Larook/STM_Stewart/README.md

# STM_Stewart
Bachelor's thesis in the Warsaw University of Technology.

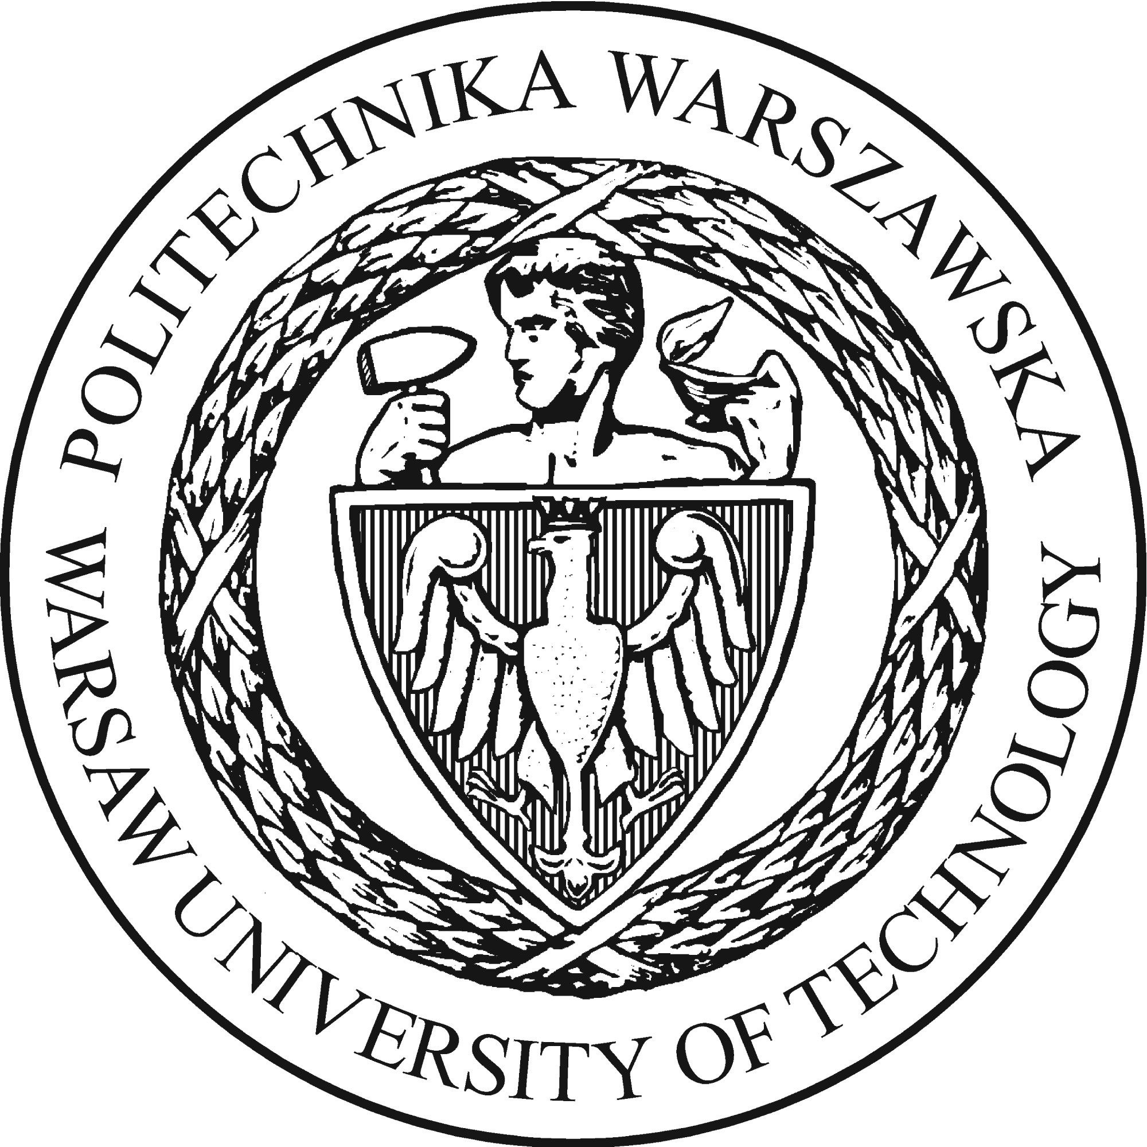
[picture p1: LaTeX_thesis/Thesis_images/logopw.png]


The project's goal was to develop a 6DOF parallel manipulator known as the Stewart platform.
On top of the STM32 - based motion control an attempt to balance a metal ball on top of the platform's upper plate using the resistive touch sensor and PID controller.

- Outcome:
The structure works fine with all the movements possible, combined with gimbal-like stabilisation thanks to the used IMU.
Unfortunately the inaccuracy of servos in the joints were pointed as the main obstacle preventing from succesfull ball balancing on the limited area of top plate.

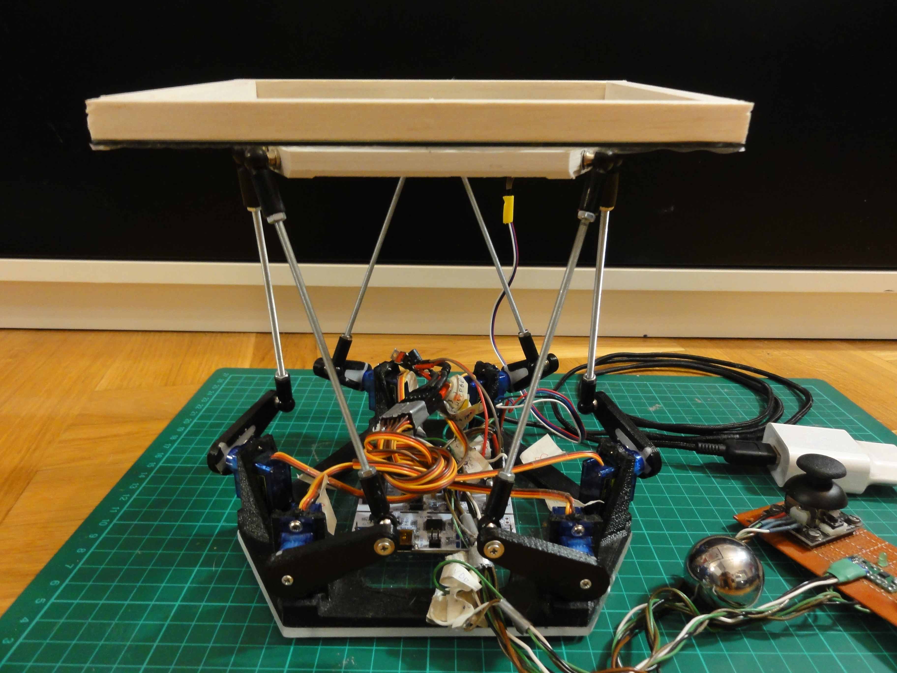
[picture p2: LaTeX_thesis/Thesis_images/Czesci_i_konstrukcja/Platforma_rzeczywista.JPG]


- State machine of operations:

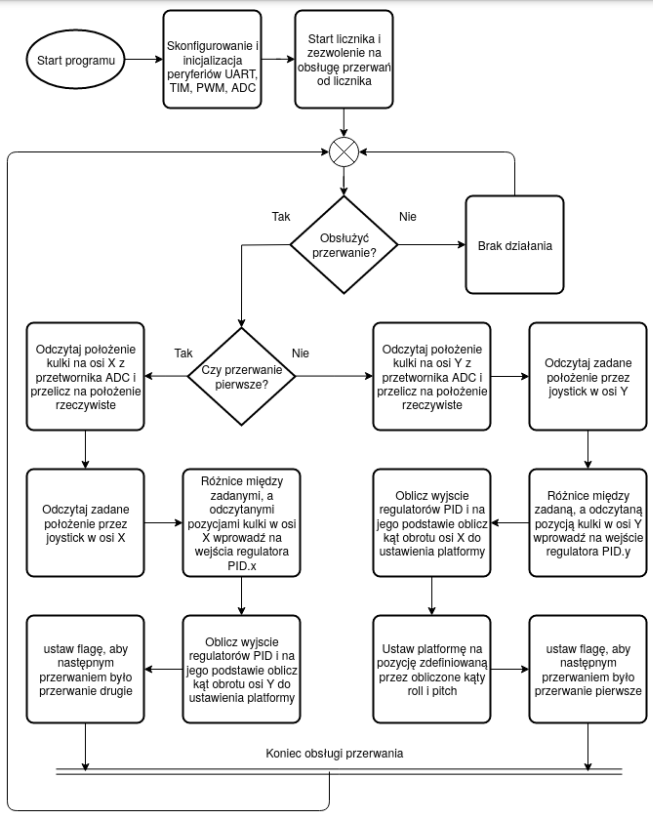
[picture p3: LaTeX_thesis/Thesis_images/statemachine.png]


- Simplified inverse kinematics model:



- Reading the touch data:

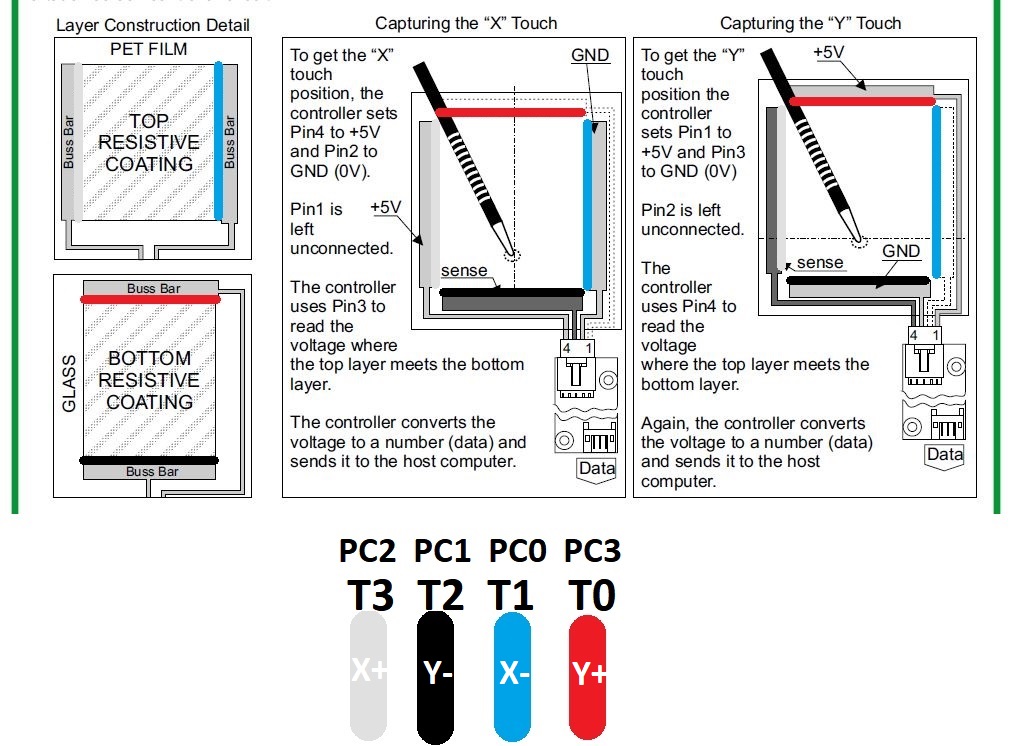
[picture p4: LaTeX_thesis/Thesis_images/TouchPanel/HOW IT SHOULD WORK.jpg]


- PID response:

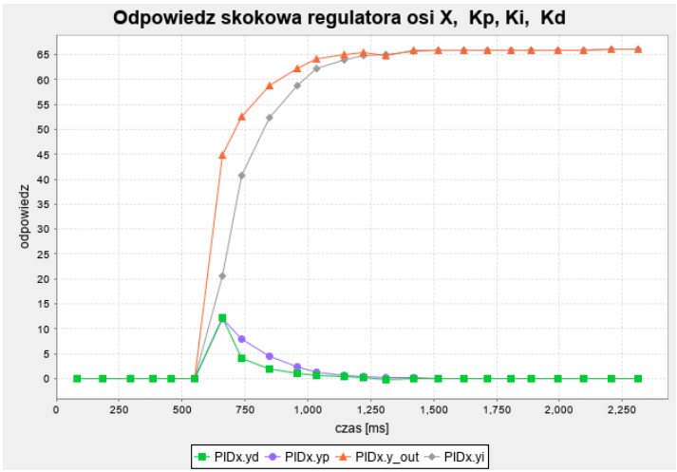
[picture p5: LaTeX_thesis/Thesis_images/step_response.png]
