Larook/STM_Stewart/STM_Stewart-final/LaTeX_thesis/Karol_Szurkowski-Stewart_Platform/tex/5-Sterowanie_polozeniem_kulki.tex

\newpage % Zaleca się otwieranie rozdziału od nowej strony.
\section{Układ sterowania położeniem kulki na platformie za pomoc regulatora PID}

\subsection{Regulator PID - co to, po co, co robi P, I, D, dlaczego to?}

\subsection{zapisany PID w kodzie}

\subsection{Schemat zamkniętej pętli sterowania z nazwami metod kodu}

\subsection{Dobor nastaw i dlaczego kurde nie działa ładnie}
