Larook/STM_Stewart/STM_Stewart-final/LaTeX_thesis/Przykladowe_Papers/chyba_wszystko_dokladnie_Modelling-and-Control-of-Ball-Plate-System.pdf

# Modelling and Control of Ball-Plate System

Final Project Report
Mohammad Nokhbeh and Daniel Khashabi Under the supervision of Dr.H.A.Talebi

Amirkabir University of Technology, 2011

Abstract

Abstract–In this report we will have a detailed look into controlling a Ball-on-Plate system apparatus. We will first derive the exact non-linear differential equations of Ball-on-Plate apparatus by the use of Lagrange-Euler equations. At the rest we derive several useful linearised model for our system. We use the linearised model to design compensator for the system. We simulate the results using non-linear model of system and evaluate the results by step responses and trajectory tracking.

## Contents

1 Introduction | 2
2 Review on Previous Works | 2
3 Mathematical Modelling | 3
3.3.3 | Complete Linearisation of Ball-on-Plate and DC Motor . | 9
4 Controller Design | 10
5 Result Evaluation | 13

1

6 Conclusions | 18
7 Acknowledgement | 18

## 1 Introduction

Balancing systems are one of most challenging problems in Control field. There are lots of platforms for this sake like cart-pole system(inverted pendulum), ball-beam system, double and multiple inverted pendulums[1].
The ball-on-plate system is a promoted version of the traditional ball-on-beam control problem. The problem consists of a plate which its deviation can be manipulated in two perpendicular directions. The goal is to carry the ball moving on the plate to a desired position, that is to control a freely rolling ball on a specific position or moving on a trajectory on the plate. In more precise way, one can do stabilization control in which the goal is to carry the ball from one specific position and hold it in the desired position or do trajectory tracking control in which the goal is to make the ball follow a predefined trajectory with the least error and in a the minimum time.

## 2 Review on Previous Works

We can classify the previous works on ball-on-plate system into to general categories. Those based in mathematical modelling and those proposing model-free controllers.
The [2] is devoted to a mechatronic design of the system which benefits a touch sensor feedback. In [1] a Fuzzy Reinforcement Learning method is proposed. The previous paper benefits a high accuracy stepping motor with 0.9 degree size of steps which is reducible by the drivers down to 1/200 of step size, i.e. 4.5 ∗ 10⁻³
. It uses precise incremental encoder (3600 ppr) which is coupled to motor’s shaft. Altogether by taking the mechanical limitations, it benefits the smallest measurable and applicable amount of rotation 0.1 degrees. It uses a 15 inches touch sensor that its output is a message packet being sent through RS-232 serial communication with 19200 bps. Thus the fastest sampling rate of the whole sensor block is 384 samples per second. This implies that the maximum
available time for decision making is 1/384 ∼= 2.6∗10⁻³ | seconds. The area of the
surface of the touch sensor on which pressure can be sensed 30.41 × 22.81cm. Sensor resolution is 1900*1900 pixels so if the sensor sensitivity is uniformly distributed on its sensitive area, then each pixel is assigned to an area approximately equals to 1.8*1.2 mm² of the surface of the sensor.
In [3] a PID neural network controller(PIDNN) based on genetic algorithm(GA) is used for control. In this approach GA is a applied in training weighting factor of multilayer feed-forward neural network in order to overcome the disadvantage

2

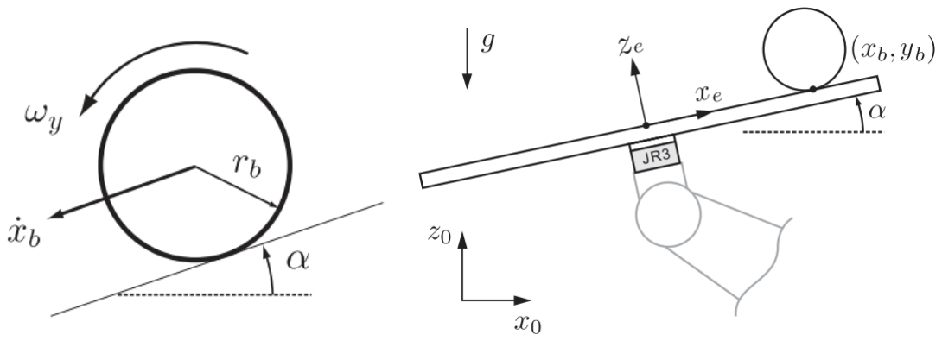
[picture p28: figure]

Figure 1: Side view of ball on plate system.

of back-propagation algorithm which falls into local minima. It is claimed that the proposed method is robust, adaptive and strong control performance.
In [2] ball position measured by a touch pad rather than a camera. In the previous paper a linear quadratic state feedback regulator was designed after the system was linearised around a few operating points. Accuracy of stabilization 5 mm. Steady state error in average was 18 mm in circle following while trajectory velocity was less than 4.2 mm/s
In [4] a hierarchical fuzzy control scheme with a TS type fuzzy tracking controller was proposed. In [5] sliding mode control with uncertain items observe compensation, is used to control a ball-on-plate system.

## 3 Mathematical Modelling

In this section we are going to derive the motion equations of system. In these part we assume following simplifications:

- There is no slipping for ball.
- The ball is completely symmetric and homogeneous.
- All frictions are neglected.
- The ball and plate are in contact all the time.

Here we derive dynamical equations of ball-on-plate system by the help of Lagrangian. The following precise mathematical equations are based on [6][4][7] ([4, 6, 7]). The Euler-Lagrange equation of ball-plate system is as followings:

d
dt

∂T
∂q˙i

−

∂T
∂qi

+

∂V
∂qi
= Qi | (1)

3

Where qi stands for i-direction coordinate, T is kinetic energy of the system, V is potential energy of system and Q is composite force.
The system has 4 degree of freedom; two in ball motion and two in inclination of plate. Here we assume the generalized coordinates of system to be (is) xb and yb ball’s position on plate and α and β the inclination of the plate. It is important to note that we assume the center of x − y coordinates be at center of plate. The kinetic energy of ball consists of its both rotational with respect to its center of mass and translational energy:

Tb =

1
2

mb

x˙

2
b + ẏ

2
b
+

1
2

Ib

ωx

2 + ωy

2
(2)

Where mb is mass of the ball and Ib is moment of inertia of the ball; ẋb and x˙ b are ball’s translational velocities along x-axis and y-axis; ωx and ωy are ball’s rotational velocities along x-axis and y-axis. The following relations between translational velocities and rotational velocities:

x˙ b = rbωy | , | yḃ = rbωx | (3)

In which rb denotes ball’s radius. By substituting equations 3 into equations 4 we will have:

Tb =

1
2
mb
x˙

2
b + ẏ

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
b + ẏ

2
b

=

1
2
mb +

Ib
rb

2

x˙

2
b + ẏ

2
b
(4)

The kinetic energy of the plate, by considering ball as a point mass which is placed in (xb, yb), , consists of the (ezafi) its rotational energy with respect to its center of mass:

Tp =

1/2(Ip + Ib)

α˙

2 + β˙2

+

1
2mb
xbα˙ + ybβ˙
2
| =

1/2(Ip + Ib)

α˙

2 + β˙2

+

1
2mb
x

2
bα˙

2 + 2xbαy˙ bβ˙ + y
2
b

β˙2

(5)

Where α and β are plate’s angle of inclination along x-axis and y-axis, respectively. Therefore ˙α and β˙ are plate’s rotational velocity. Here we can calculate the kinetic energy of system as followings:
Where α and β are plate’s angle of inclination along x-axis and y-axis, respectively. Therefore ˙α and β˙ are plate’s rotational velocity. Here we can calculate the kinetic energy of system as followings: (paragraf tekrari)

T = Tb + Tp
=

1/2
mb +

Ib
rb

2

x˙

2
b + ẏ

2
b
+

1/2(Ip + Ib)

α˙

2 + β˙2

+

1
2mb
x

2
bα˙

2 + 2xbαy˙ bβ˙ + y
2
b

β˙2

(6)

The potential energy of the ball relative (the relative potential) to horizontal plane in the center of the inclined plate can be calculated as:

4

Vb = mbgh = mbg (xb sin α + yb sin β) | (7)

Here we can derive the system’s equation by Lagrangian and equations 4-7:

L = Tb + Tp − Vb | (8)

We use L to derive system’s equations:

∂T
∂α˙

= (Ip + Ia) ˙αx + mbxb

xbα˙ + ybβ˙
,

∂L
∂α = mg cos α | (9)

∂T
∂β˙

= (Ip + Ia)β˙
x + mbyb
ybβ˙ + xbα˙
,

∂L
∂β = mg cos β (10)

∂T
∂xḃ

=

mb +

Ib
r

2
b
xḃ ,

∂L
∂xb

= mb

xbα˙ + ybβ˙
α˙ | (11)

∂T
∂yḃ

=

mb +

Ib
r

2
b
yḃ ,

∂L
∂yb

= mb

xbα˙ + ybβ˙
β˙ | (12)

We assume generalized toques as τx and τy which are exerted torques on the plate. From Lagrange-Euler equation we can write:

d
dt

∂T
∂α˙ −

∂L
∂α | = | (Ip + Ib) ¨α + mbx

2α¨ + 2mbxbxḃα˙ + mbxbybα¨ + mbx˙ bybβ˙ + mbxby˙β˙ − mbg cos α = τx

(13)

d
dt

∂T
∂β˙ −

∂L

∂β | = | (Ip + Ib) β¨ + mby
2
b

β¨ + 2mbybyḃβ˙ + mbxbybβ¨

+ mbyḃxbα˙ + mbybx˙ bα˙ − mbg cos β = τy

(14)

d
dt

∂T
∂x˙ b

−

∂L
∂x˙ b

=

mb +

Ib
r

2
b
x¨b − mb
xbα˙ + ybβ˙
α˙ + mbg sin α = 0 (15)

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
mb +

Ib
r

2
b
y¨b − mb
ybβ˙ + xbα˙
α˙ + mbg sin β = 0 (16)

So the non-linear differential equations for the ball-plate-system as followings:
mb +

Ib
r

2
b
x¨b − mb
xbα˙

2 + ybα˙ β˙

+ mbg sin α = 0 | (17)
mb +

Ib
r

2
b
y¨b − mb
ybβ˙² + xbα˙ β˙
+ mbg sin β = 0 | (18)

τx =

Ip + Ib + mbx

2
b

α¨ + 2mbxbx˙ bα˙ + mbxbybβ¨ +mx˙ bybβ˙ + mbxbyḃβ˙ + mbgxb cos α

(19)

τy =

Ip + Ib + mby

2
b

¨β + 2mbybyḃβ˙ + mbybxbα¨ +mbx˙ bybα˙ + mbxbyḃα˙ + mbgyb cos β

(20)

5

The equations (18)-(17) shows the relation between ball’s state and plate’s state that is plate’s inclination. The equations (19)-(20) shows the effect of external torque on the ball-on-plate system. It is obvious that working with such complex equations is too hard. So in order to do Laplace analysis on system’s transfer function, we derive the linearised model of system in neighbourhood of working state.

### 3.1 Plant Values:

In this report we use the values that are shown in following table that are based on [4]:

Parameter | Description | Value
mb | Mass of the ball | 0.11kg
rb | Radius of the ball | 0.02m
Sp | Dimension of the plate | 1.0 × 1.0m²
vmax | Maximum velocity of the ball | 4mm/s
mp | Mass of the plate | 0.1kg
Ip | Mass moment of inertia of the plate | 0.5kg.m²
Ib | Mass moment of inertia of the ball | 1.76 × 10⁻⁵kg.m²
g | Gravitational acceleration | 9.81

### 3.2 Motor Model

Here we assume (use or consider) an Armature-Controlled DC motor which it’s block diagram is shown in figure 2. The motor uses armature current ia as the control variable. The stator field can be established by a field coil current. The detailed description of equations can be found in [8] and [9]. When we have a constant current in the field coil, we have the following postulates:

Tm(s) = KmIa(s)
V (s) = (Ra + Las)Ia(s) + Ea(s)
V (s) = Kbω(s)
=⇒ Ia(s) = [V (s) − Kbω (s)] / [Ra + Las]

The absolute torque exerted on the load can be found by:

TL(s) = Tm(s) − Td(s)

By letting Td(s) = 0 and considering GL(s) = ωL(s)
TL(s)

to the load torquevelocity characteristic, one can find the input-output transfer function:

G(s) = θL(s)
V (s) =

KmGL(s)
s[(Ra+sLa)+KmKbGL(s)]

6

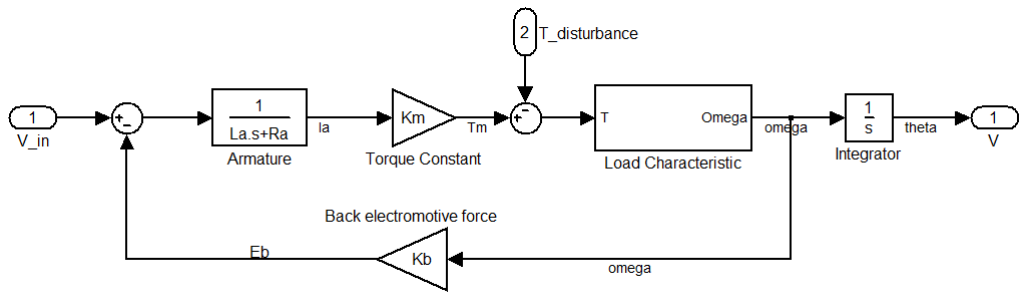
[picture p29: figure]

Figure 2: Block diagram for an armature-controlled DC motor.

We can assume an approximate function for load characteristic as following : TL(s) = 1 Js+B Where J stands for load inertia and B for load damping. We
rewrite the motors transfer function in this way:

G(s) = θL(s)
V (s) =

Km
s[(Ra+sLa)(Js+B)+KmKb]

We assume following typical values for DC motor[10]:

Parameter | Description | Value
Km | Toque constant | 6.876 × 10⁻⁴N.m/A
Kb | Back-emf constant | 7.2 × 10⁻⁵V /rpm or 1.9099 × 10⁻⁷V.s/rad
Jm | Rotor inertia | 1 × 10⁻³N.m.s²/rad
B | Rotor damping | 10⁻⁸N.m/(rad/s)
τf | Field time constant | 1ms
τ | Rotor time constant | 100ms
R | Armature resistance | 3.9Ω
L | Armature inductance | 12 × 10⁻⁶H
Pmax | Maximum output power | 0.25hp
Ts | Stall torque | −4N × m 2.4
Vf l | Rated DC supply voltage | 1.5V

### 3.3 Model Linearisation

In this part we will derive several linearised model of system that we will use them in next sections.

### 3.3.1 Linearised Model of a Ball-on-Plate

The approximate value for a solid ball’s moment of inertia is Iball =

2
5mbr

2
b
Therefore equations (17) and (18) can be written as:

7

mb

5
7

x¨b −

xbα˙

2 + ybα˙ β˙

+ g sin α
= 0 | (21)

mb

5
7

y¨b −

ybβ˙

2
+ xbα˙ β˙
+ g sin β
= 0 | (22)

We can linearise above equation by assuming:

- Small angle of inclination for the plate(up to ± 5

◦
): α 1 and β 1
=⇒ sin α ' α, sin β ' β
- Slow rate of change for the plate: ˙α 0 and β˙ 0 =⇒ α˙ β˙ ' 0 , ˙α | 2 ' 0,
β˙

2
' 0.

5
7
x¨b + gα = 0 | (23)

5
7
y¨b + gβ = 0 | (24)

By linearising the above equations, we find two separate differential equations for each of x and y axis. Note that we can use above linear differential equations to estimate the ball-on-plate system’s states xb, yb, ẋb, ẏb. By assuming α(s) and β(s) as inputs to ball-on-plate system, we find the transfer functions:

Px(s) = Xb(s)
α(s)

=

g
5/7 s

2

(25)

Py(s) = Yb(s)
β(s)

=

g
5/7 s

2

(26)

### 3.3.2 State-space Model of System

One can write state equations of ball-on-plate system by considering Equations (17)-(20)[3]. As mentioned τx and τ y are toques exerted on the plane(or on the ball from the earth) in y-axis and x-axis direction respectively. By defining state variables X = [x1, x2, x3, x4, x5, x6]

T = [xb, x˙ b, α, α, y ˙ b, yḃ, β, β˙ ]

T
,
U = [ux, uy]

T = [α, β]

T
and constant value B = m/ m + Ib/r²
b
| we write the
non-linear state equation x˙ = f(x, u):

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
B(x1x

2
4 + x4x5x8 − g sin x3)
x4
0
x6
B(x5x

2
8 + x1x4x8 − g sin x7)
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
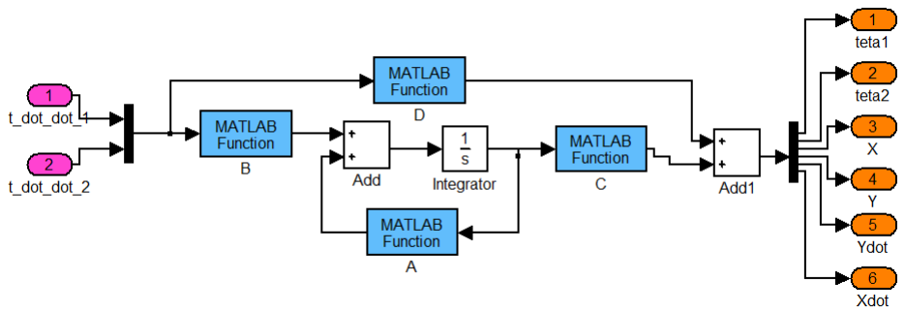
[picture p30: figure]

Figure 3: Block diagram of the Plant.

Because of the low velocity and acceleration of the plate rotation(|α˙ | 1 and

β˙

1) we can omit the coupling term in f(x, u) and divide the system into to sub-systems and control them independently.

x1
x2
x3
x4

=

x2
B(x1x

2
4 − g sin x3)
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
B(x5x

2
8 − g sin x7)
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
The implementation of the plant is shown in figure 3.

### 3.3.3 Complete Linearisation of Ball-on-Plate and DC Motor

We use MATLAB’s internal function to generate a linear model of our non-linear model. First we consider (ezafi) are going to make a linear of model which consists of Plant which is ball-on-plate and a DC motor. The goal of this model is to consider the loading effect of ball and plate on the motor. Because if have ball and plates that have considerable weight, they affect the position/velocity of motor. The complete Simulink model of system is show in figure (5).
The linearisation must be done in infinitesimal neighbourhood of equilibrium point. The equilibrium point is where speed and its derivatives are zero. By considering zero value for velocity and acceleration terms, we find the following point as equilibrium:

9

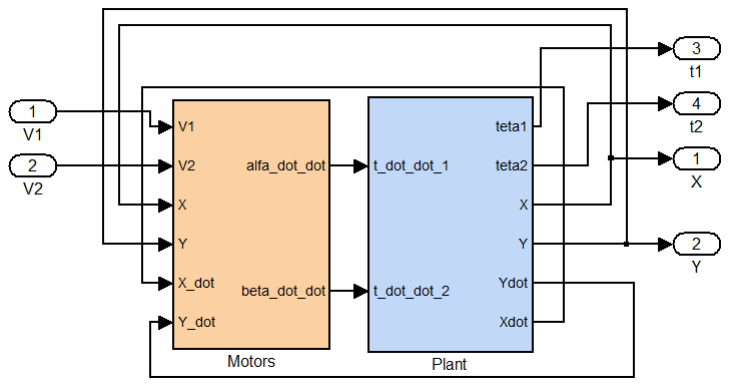
[picture p31: figure]

Figure 4: Block diagram of the whole system.

X = [xb, x˙ b, α, α, y ˙ b, yḃ, β, β˙
]

T = [0, 0, 0, 0, 0, 0, 0, 0]T

MATLAB CODE:
DefineConstants();
[A,B,C,D]=linmod(’PM’,[0,0,0,0,0,0,0,0,0,0,0,0,0,0],[0,0]) sys = ss(A,B,C,D)
sys2=tf(sys)

The resulting output transfer functions are as followings:

X(s) V1(s) = | −802.2
s | 5+3.25×10⁵s 4−15.09s−4.905×10⁶
Y (s) V2(s) = | −802.2
s | 5+3.25×10⁵s 4−15.09s−4.905×10⁶
If we plot the root-locus plot of the above transfer function, we will get the figure (6).

## 4 Controller Design

In this section we are going to design compensator for the transfer functions we derived in previous parts. Here we propose several methods of compensation and in

### 4.1 Single Compensator in Open-Loop

The first compensator consists of only a compensator in open-loop. Unfortunately this system is unproper and DC gain of this controller is 100 (for stabalizing), it’s settling time (Ts) and overshoot is also unacceptable.

10

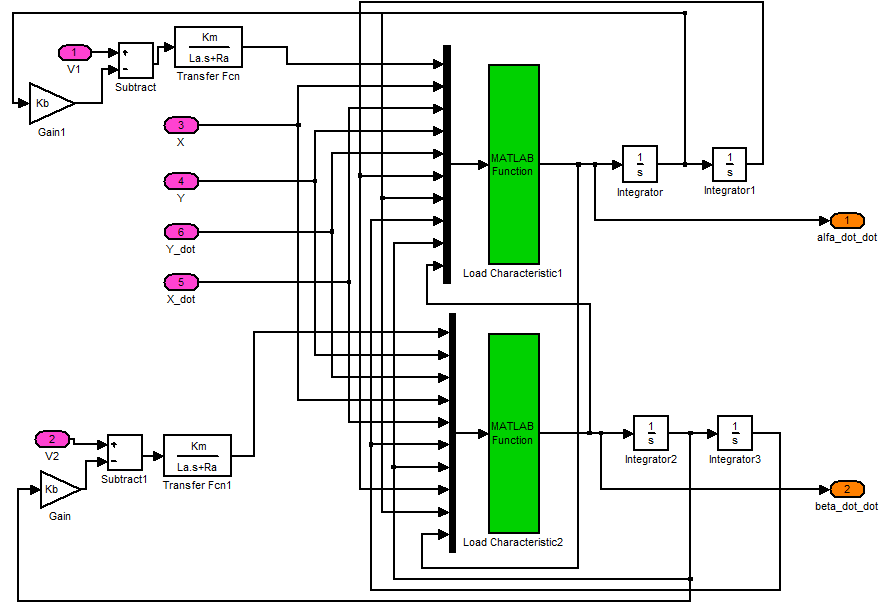
[picture p32: figure]

Figure 5: Block diagram of the motors with non-linear load characteristics.

C(s) = −3461538.4615(s+0.01)² (s+2)(s

2+10s+26)
(s−1.8)(s+100)
Gain | Poles | Zeros
100 | 2 | 5

Root-locus and step response of the first compensator are shown in figure (7).

### 4.2 Compensator With Prefilter

The second compensator consists of a compensator and a prefilter. Unlike first compensator this system is proper and DC gain and percent overshoot of this controller is acceptable but this compensator have a Ts = 15s settling time.

C(s) = −0.4294s

5−139600s

4−323700s

3−705500s

2−1.202×10⁶
s−798.5
s

5+9.971s

4+43.77s

3+111.2s

2+195.5s
F(s) = | 798.5
0.4294s

5+139600s

| 4+323700s 3+705500s

2+1.202×10⁶s+798.5

Gain | Poles | Zeros | Prefilter poles
4.08 | 5 | 5 | 5

In order to find better compensator, we change the architecture add following add a new controlling loop. The compensator at the rest of report are designed to control plant and previous controller.

11

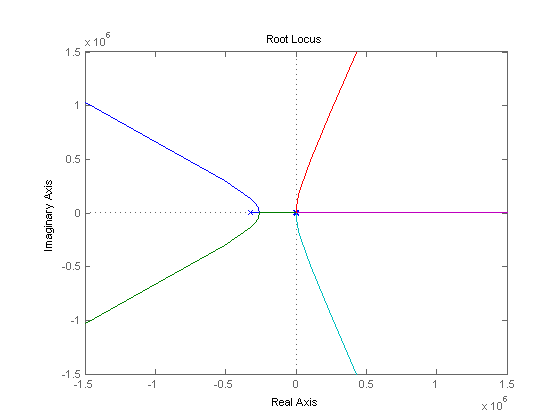
[picture p33: figure]

Figure 6: Pole-zero map of system’s transfer function.

### 4.2.1 Multi-loop controller 1

the following system is designed to make the settling time of second compensator appropriate. this compensator’s aim is to get have overshoot but rapid timerise.

Gain | Poles | Zeros | Prefilter poles
1.6 | 8 | 8 | 1

F(s) = 16.12
s+10
C(s) =

7.296×10¹³s

8+5.597×10¹⁴s

7+1.906×10¹⁵s

6+3.729×10¹⁵s

5+4.586×10¹⁵s

4+3.613×10¹⁵s

3+1.788×10¹⁵s

2+4.917×10¹⁴s+6.251×10¹³
s

8+400s

7+7×10⁴s

6+7×10⁶s

5+4.375×10⁸s

4+1.75×10¹⁰s

3+4.375×10¹¹s

2+6.251×10¹²s+3.907×10¹³

### 4.2.2 Multi-loop controller 2

the following compensator is desinged to make the settling time of second compensator appropriate. this compensator’s aim is to critical damp mode.

Gain | Poles | Zeros | Prefilter poles
.6 | 8 | 8 | 1

F(s) = 26.66
s+10
C(s) =

2.736×10¹³s

8+2.099×10¹⁴s

7+7.148×10¹⁴s

6+1.398×10¹⁵s

5+1.72×10¹⁵s

4+1.355×10¹⁵s

3+6.706×10¹⁴s

2+1.844×10¹⁴s+2.344×10¹³
s

8+400s

7+7×10⁴s

6+7×10⁶s

5+4.375×10⁸s

4+1.75×10¹⁰s

3+4.375×10¹¹s

2+6.251×10¹²s+3.907×10¹³

12

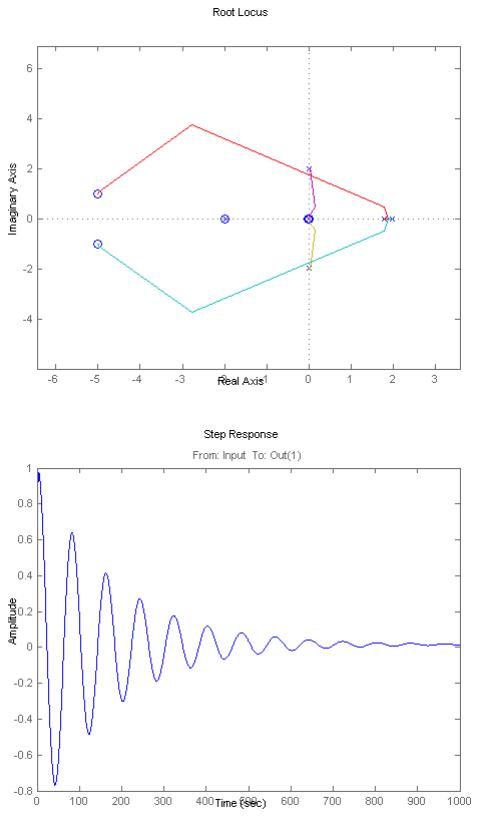
[picture p34: figure]

Figure 7: Root-locus and step response of the first compensator.

## 5 Result Evaluation

In this part we are going to evaluate the results we got from previous parts. The main goal of this part part is to check the validity of the previous results and whether they are valid for the case of main non-linear equations. For this goal, we designed the comprehensive non-linear simulator to check the validity of results.

13

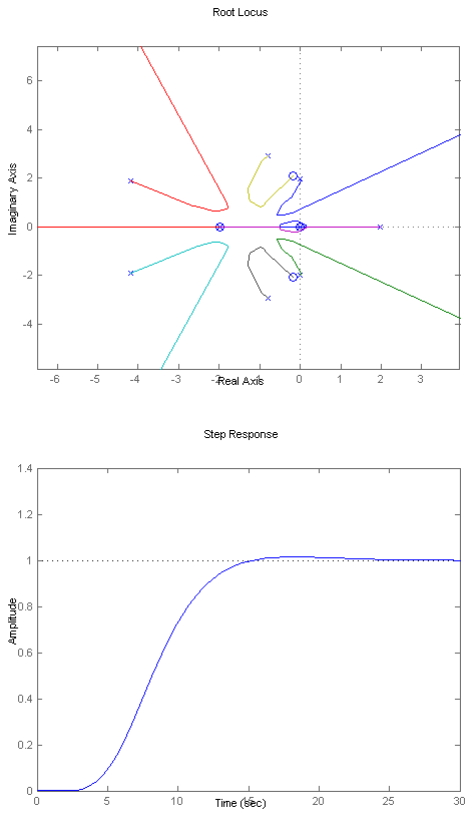
[picture p35: figure]

Figure 8: Root-locus and step response of the second compensator.

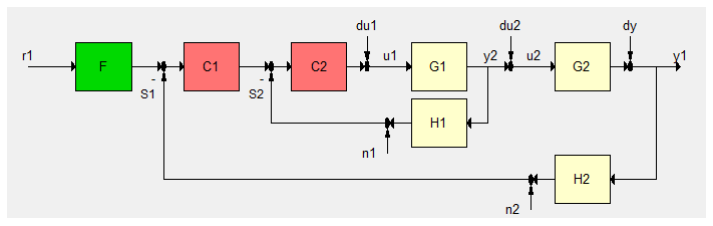
[picture p36: figure]

Figure 9: Architecture of added controlling loop.

14

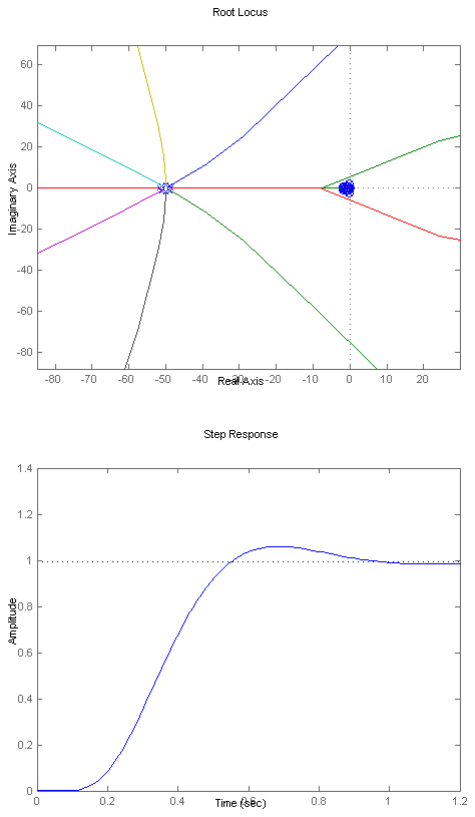
[picture p37: figure]

Figure 10: Root-locus and step response of the third compensator.

### 5.1 Non-linear Simulation

In order to have a realistic evaluation of the designed compensator and its operation we need to design a non-linear simulator by the use of primary non-linear equations (17)-(20).

15

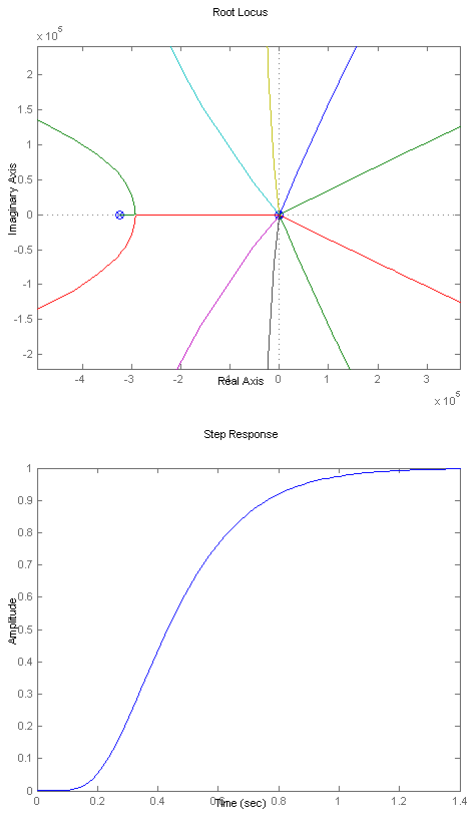
[picture p38: figure]

Figure 11: Root-locus and step response of the forth compensator.

### 5.1.1 Trajectory Tracking Using Non-linear Simulator

The task of tracking a trajectory is one of important tasks that one controller must be able to accomplish. In figure (14) the results of several tracking experiments are shown.

### 5.1.2 Coulomb Friction

Despite the complex microscopic origins of Coulomb friction, we can model it by simple models. One popular model for formulating the Coulomb friction is as following[11] [12] :

16

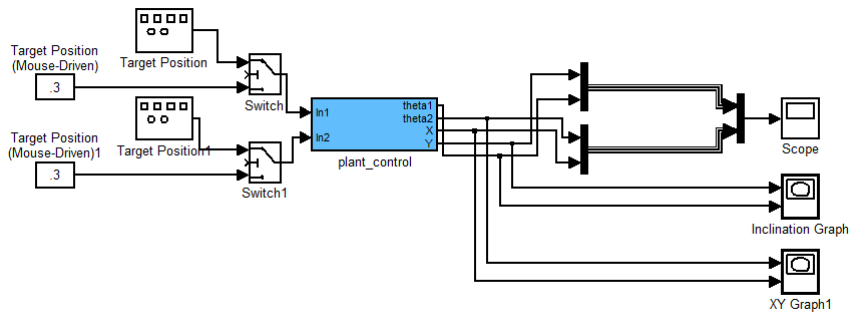
[picture p39: figure]

Figure 12: Main block diagram for simulation in presence of designed controller.

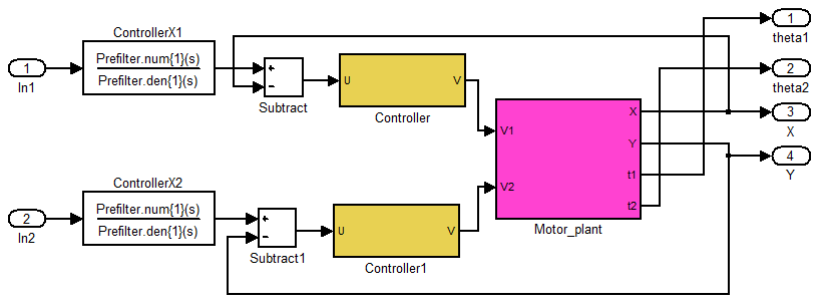
[picture p40: figure]

Figure 13: The designed controllers and non-linear implementation of the system.

Tf = ρ tanh (ηx˙)

Where ρ and η are constant values. For large values of η the Coulomb friction is similar to a Sign Function and for lower values of η we get softer Coulomb friction, as shown in figure (15).

### 5.2 Two-Dimensional Overshoot

As it is described above system’s model is discretely described in each dimension and there is no relation between two subsystem. Consider measuring of overshoot of system, overshoot is the excessive value which systems takes for speed, but what is the relationship between the overshoot measured in each subsystem and overshoot of system. The output signal will be the joint of both systems and because both system’s overshoot times are not equal, system will track an unknown trajectory which is for sure in the rectangle of O1 × O2. Overshoot is usually considered in building of the physical system, the system’s bounds are based on overshoots measured. Considering all above a new measurement of

17 overshoot can be considered which is maximum distance from the zero point in the 2D path. Figure 16 2d-overshoot point (the point with maximum distance of zero) of a joint system consisting of two standard 2nd order linear subsystems are drawn. Assuming ωn1 = ωn2 this will be just in the corner of rectangle, but when ωn1 6= ωn2 this point will be on one of the sides.

H1(s) = ω

2
n1
s
| 2+2ζ1ωn1+ω²
n1
H2(s) = ω

2
n2
s
| 2+2ζ2ωn2+ω²
n2
In figure 17 the 2d-overshoot of different systems with different ζ1 = ζ2 is shown.It shows that systems which their natural frequencies of their subsystems are equal have the worse 2d-overshoot: √
| 2(O1d) (It is also proven with some
other experiments). For example when ωn1 = 1, ωn2 = 1, ζ1 = ζ1 = .6, O2d = 1.5482, but for ωn1 = 1, ωn2 = .5, ζ1 = ζ1 = .6, O2d = 1.4767.

## 6 Conclusions

In this report we derived complete equations of ball-on-plate system. We did linearisation analysis to find the transfer function of the system. We designed several compensator and at the rest made some analysis on the results. We tried several trajectory tracking tasks. The final results showed that the designed controllers had almost acceptable performances.

## 7 Acknowledgement

The authors would like to thank all their classmates, friends and masters that helped on this project. They would like to thank Ehsan Omidi and Farokh Atashzar for their illuminating discussion and ideas. They also knowledge Dr.H.A.Talebi for his comprehensive and off course perfect instructions.

## References

[1] N. Mohajerin, M. B. Menhaj, and A. Doustmohammadi, “A reinforcement learning fuzzy controller for the ball and plate system,” in Proc. IEEE Int Fuzzy Systems Conference, 2010, pp. 1–8.
[2] S. Awtar, C. Bernard, N. Boklund, A. Master, D. Ueda, and K. Craig, “Mechatronic design of a ball-on-plate balancing system,” Mechatronics, vol. 12, no. 2, pp. 217–228, 2002.
[3] X. Dong, Z. Zhang, and C. Chen, “Applying genetic algorithm to on-line updated pid neural network controllers for ball and plate system,” in Proc.

18

Fourth Int Innovative Computing, Information and Control (ICICIC) Conf, 2009, pp. 751–755.

[4] X. Fan, N. Zhang, and S. Teng, “Trajectory planning and tracking of ball and plate system using hierarchical fuzzy control scheme,” Fuzzy Sets and Systems, vol. 144, no. 2, pp. 297–312, 2004.
[5] D. Liu, Y. Tian, and H. Duan, “Ball and plate control system based on sliding mode control with uncertain items observe compensation,” in IEEE International Conference on Intelligent Computing and Intelligent Systems, ICIS09, vol. 2. IEEE, 2009, pp. 216–221.
[6] K. kyu Lee, G. Btz, and D. Wollherr, “Basketball robot: Ball-on-plate with pure haptic information,” in IEEE International Conference on Robotics and Automation, May 2008.
[7] D. Yuan and Z. Zhang, “Modelling and control scheme of the ball-plate trajectory-tracking pneumatic system with a touch screen and a rotary cylinder,” Control Theory & Applications, IET, vol. 4, no. 4, pp. 573–589, 2010.
[8] F. Golnaraghi and B. Kuo, Automatic control systems, vol. 2.
[9] R. Dorf and R. Bishop, Modern control systems, 11th ed. Pearson Printice Hall, 2008.
[10] W. Bolton, Mechatronics: electronic control systems in mechanical and electrical engineering. Prentice Hall, 2004.
[11] D. Haessig and B. Friedland, “On the modeling and simulation of friction,” in American Control Conference. IEEE, 2009, pp. 1256–1261.
[12] C. S.J. and T. R.W., “On the modeling of coulomb friction,” UNKNOWN JOURNAL OR CONFERENCE, 1998.

19

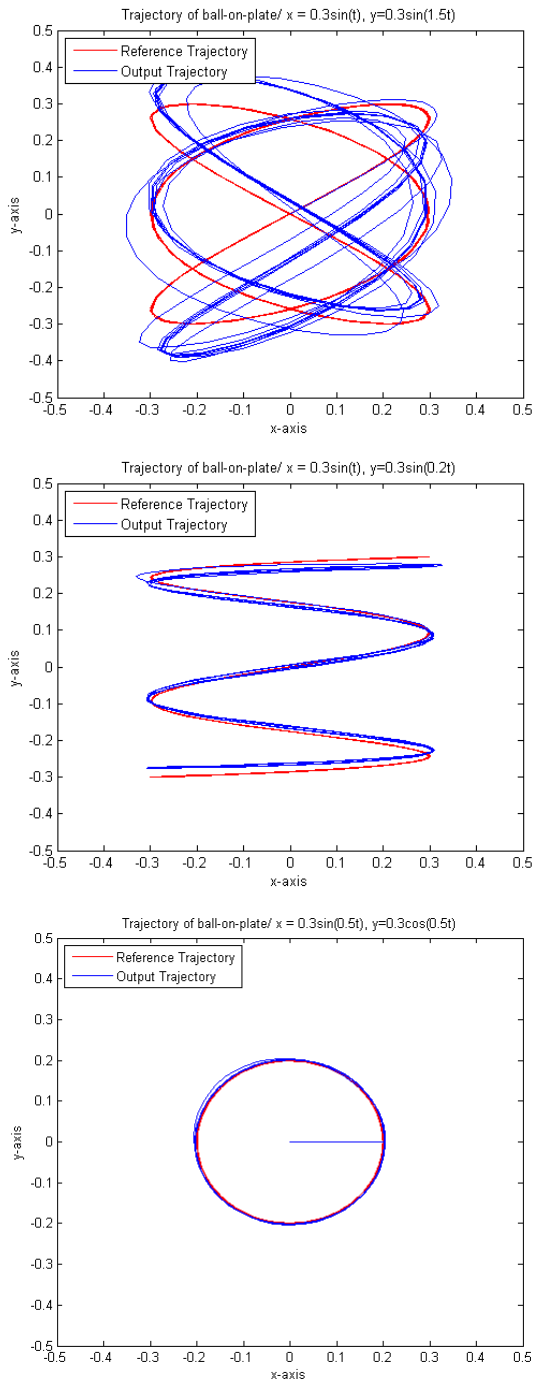
[picture p41: figure]

Figure 14: Results of trajectory tracking.

20

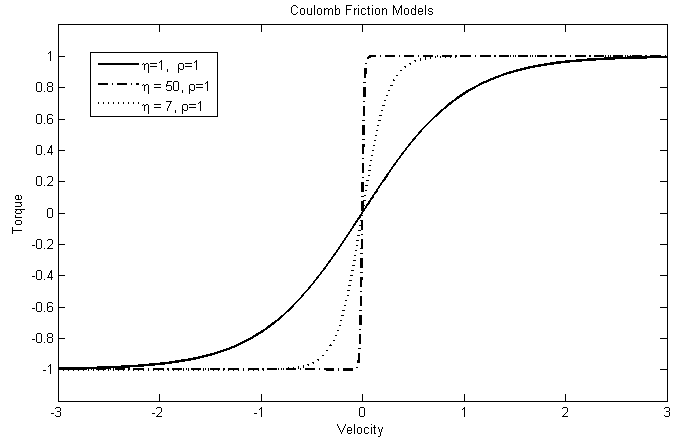
[picture p42: figure]

Figure 15: Coulomb Friction Models.

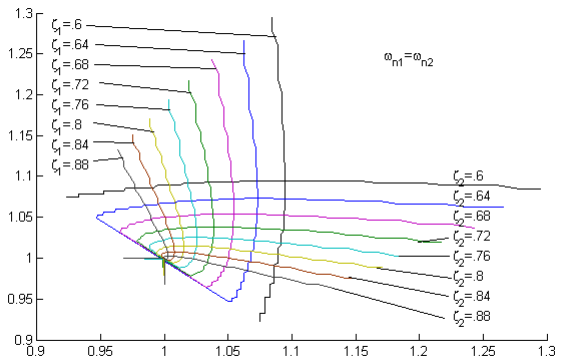
[picture p43: figure]

Figure 16: 2-D overshoot place. This figure shows the point which has the maximum distance from zero for different parameters of ζ1 and ζ2. Each curve is a class of systems which have one subsystem and the other subsystem differs.

21

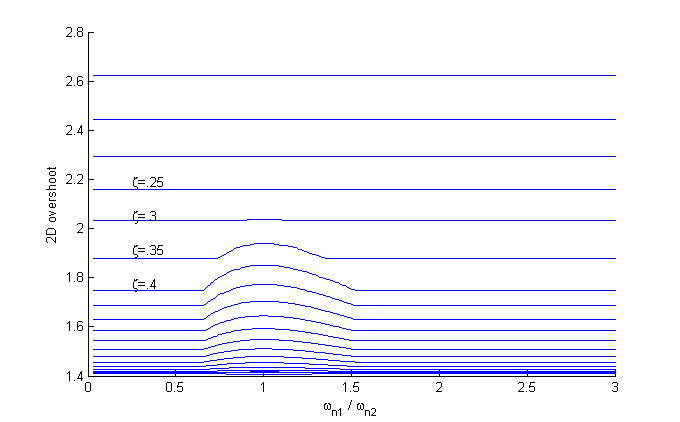
[picture p44: figure]

Figure 17: 2-D overshoot. This figure shows the the maximum distance from zero for different systems with ζ1 = ζ2 according to their subsystems natural frequencies ratios.

22
