Larook/STM_Stewart/STM_Stewart-final/LaTeX_thesis/Karol_Szurkowski-Stewart_Platform/main.tex

%%%%%%%%%%%%%%%%%%%%%%%%%%%%%%%%%%%%%%%%%%%%%%%%%%%%%%%
%% Engineer & Master Thesis, LaTeX Template          %%
%% Copyleft by Piotr Woźniak & Artur M. Brodzki      %%
%% Faculty of Electronics and Information Technology %%
%% Warsaw University of Technology, Warsaw, 2019     %%
%%%%%%%%%%%%%%%%%%%%%%%%%%%%%%%%%%%%%%%%%%%%%%%%%%%%%%%

% dobry wzor do pisania pracki wg. prof doc dr mag inz Wiraszki
%%https://www.overleaf.com/read/kxhnmbgdyjnb

\documentclass[
    left=2.5cm,         % Sadly, generic margin parameter
    right=2.5cm,        % doesnt't work, as it is
    top=2.5cm,          % superseded by more specific
    bottom=3cm,         % left...bottom parameters.
    bindingoffset=6mm,  % Optional binding offset.
    nohyphenation=false % You may turn off hyphenation, if don't like. 
]{eiti/eiti-thesis}

\usepackage[polish]{babel}
\usepackage[
    backend=bibtex,
    style=ieee
]{biblatex}
\usepackage{csquotes}
\usepackage{wrapfig}
\usepackage{graphicx}

\graphicspath{{img/}}             % Katalog z obrazkami.
\addbibresource{bibliografia.bib} % Plik .bib z bibliografią

%----------------------------------------
% Twierdzenia i definicje;
% tutaj ew. tłumaczymy te terminy
% na inne języki
%----------------------------------------
\newtheorem{theorem}{Twierdzenie}
\newtheorem{lemma}{Lemat}
\newtheorem{corollary}{Wniosek}
\newtheorem{definition}{Definicja}
\newtheorem{axiom}{Aksjomat}
\newtheorem{assumption}{Założenie}

%----------------------------------------
% Spis rysunków, tablic i załączników;
% tutaj ew. tłumaczymy te terminy
% na inne języki
%----------------------------------------
\AtBeginDocument{
    \renewcommand{\listfigurename}{Spis rysunków}
    \renewcommand{\listtablename}{Spis tabel}
    \renewcommand{\tablename}{Tabela}
}

\begin{document}

%--------------------------------------
% Strona tytułowa
%--------------------------------------
\EngineerThesis % dla pracy inżynierskiej mamy \EngineerThesis
\instytut{XXXXXX}
\kierunek{Automatyka i Robotyka Stosowana}
\specjalnosc{XXXXXX}
\title{
    Niepotrzebnie długi i skomplikowany tytuł pracy \\ 
    coś o platformie Stewarta - manipulatorze o sześciu stopniach swobody 
}
\engtitle{ % Tytuł po angielsku do angielskiego streszczenia
    Unnecessarily long and complicated thesis' title \\
    difficult to read, understand and pronounce
}
\author{\{Imię i Nazwisko\}}
\album{XXXXXX}
\promotor{XXXXXX}
\date{\the\year}
\maketitle

%--------------------------------------
% Streszczenie po polsku
%--------------------------------------
\streszczenie \lipsum[1-3]
\slowakluczowe XXX, XXX, XXX
\newpage

%--------------------------------------
% Streszczenie po angielsku
%--------------------------------------
\abstract \kant[1-3]
\keywords XXX, XXX, XXX
\newpage

%--------------------------------------
% Oświadczenie o autorstwie
%--------------------------------------
\makeauthorship
\blankpage

%--------------------------------------
% Spis treści
%--------------------------------------
\thispagestyle{empty}
\tableofcontents
\cleardoublepage

%--------------------------------------
% Rozdziały
%--------------------------------------
\input{tex/1-Wstep.tex}         % W długich pracach
\input{tex/2-Projektowanie_konstrukcji_mechanicznej_i_dobor_komponentow.tex}    % wygodnie jest trzymać
\input{tex/3-Zagadnienie_kinematyki_odwrotnej_platformy.tex}
\input{tex/4-Wykorzystanie_panelu_dotykowego.tex} % każdy rozdział w osobnym pliku. 
\input{tex/5-Sterowanie_polozeniem_kulki.tex}

\newpage % Zaleca się otwieranie rozdziału od nowej strony
\section{Podsumowanie}      % Ale można też pisać w jednym. 
\lipsum[5-7]

%--------------------------------------------
% Literatura
%--------------------------------------------
\newpage
\printbibliography

%--------------------------------------------
% Spisy (opcjonalne)
%--------------------------------------------
\newpage

% Wykaz symboli i skrótów.
% Pamiętaj, żeby posortować symbole alfabetycznie
% we własnym zakresie. Ponieważ mało kto używa takiego wykazu, 
% uznałem, że robienie automatycznie sortowanej listy
% na poziomie LaTeXa to za duży overkill. 
% //AB
\vspace{0.8cm}
\begin{acronym}
    \item \textbf{EiTI} -- Wydział Elektroniki i Technik Informacyjnych
    \item \textbf{PW} -- Politechnika Warszawska
\end{acronym}
\vspace{1cm}                % vertical space

\listoffigures              % Spis obrazków. 
\vspace{1cm}                % vertical space
\listoftables               % Spis tabel. 
\vspace{1cm}                % vertical space

% TUTAJ WRZUCAM WSZYSTKIE LINKI NA RAZIE - PDFY I ZDJECIA
\begin{appendix}            % Spis załączników.  
    \item https://arxiv.org/pdf/1712.02923.pdf
    \item https://wiku.wordpress.com/2007/05/23/stewart-platform/
    \item https://ovaktechnologies.com/wp-content/uploads/2016/07/Stewart\%20Platform.jpg
    \item https://www.researchgate.net/figure/Coordinates-of-6-DOF-Stewart-platform\_fig1\_264815673
    \item https://repository.up.ac.za/bitstream/handle/2263/25175/01chapter1.pdf?sequence=2
    \item http://www.hagenbuch.ch/hagenbuch/englisch/Download_Produkte/Hexapod\%20Applications.pdf
    \item https://ch.mathworks.com/company/newsletters/articles/creating-a-stewart-platform-model-using-simmechanics.html
    \item https://www.researchgate.net/publication/224831217\_Dynamic\_Modeling\_and\_Simulation\_of\_Stewart\_Platform
    \item http://www.parallemic.org/Reviews/Review007.html
\end{appendix}

% Możesz też dodać swój własny spis, 
% np. spis algorytmów. 
% \begin{spis}{algorytmów}
%     \item Algorytm 1.
%     \item Algorytm 2.
% \end{spis}

\end{document} % Dobranoc.
