Larook/STM_Stewart/STM_Stewart-final/LaTeX_thesis/Karol_Szurkowski-Stewart_Platform/tex/4-Wykorzystanie_panelu_dotykowego.tex

\newpage % Zaleca się otwieranie rozdziału od nowej strony.
\section{Budowa i wykorzystanie rezystancyjnego panelu dotykowego}

\subsection{Roznice miedzy rezystancyjnym a pojemnosciowym panelem dotykowym}

\subsection{Skomplikowany sposob na odczytywanie polozenia i zmiana konfiguracji pinow w trakcie wykonywania programu}

\subsection{Majac wyniki odczytow z przetwornika ADC trzeba je zrzutować na wartości mówiące coś w rzeczywistości - mapowanie za pomocą algorytmów wykorzystywanych do wyświetlaczy dotykowych + kod w Pythonie}
