Larook/STM_Stewart/LaTeX_thesis/Thesis_images/Czesci_i_konstrukcja/dostepne_timery_pwm_13.png

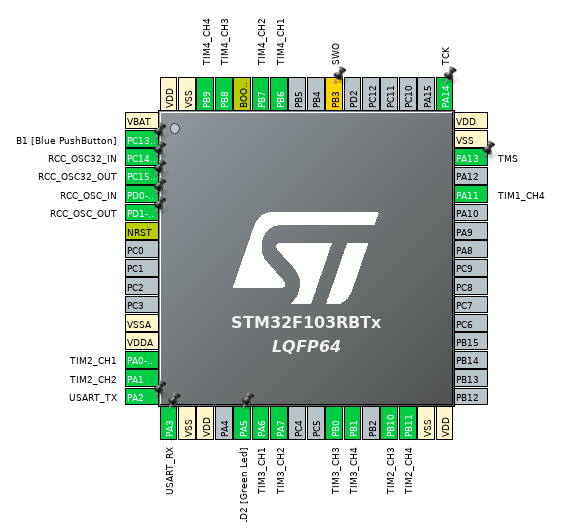
LaTeX_thesis/Thesis_images/Czesci_i_konstrukcja/dostepne_timery_pwm_13.png
