Larook/STM_Stewart/LaTeX_thesis/Thesis_images/Czesci_i_konstrukcja/Schemat_elektryczny.png

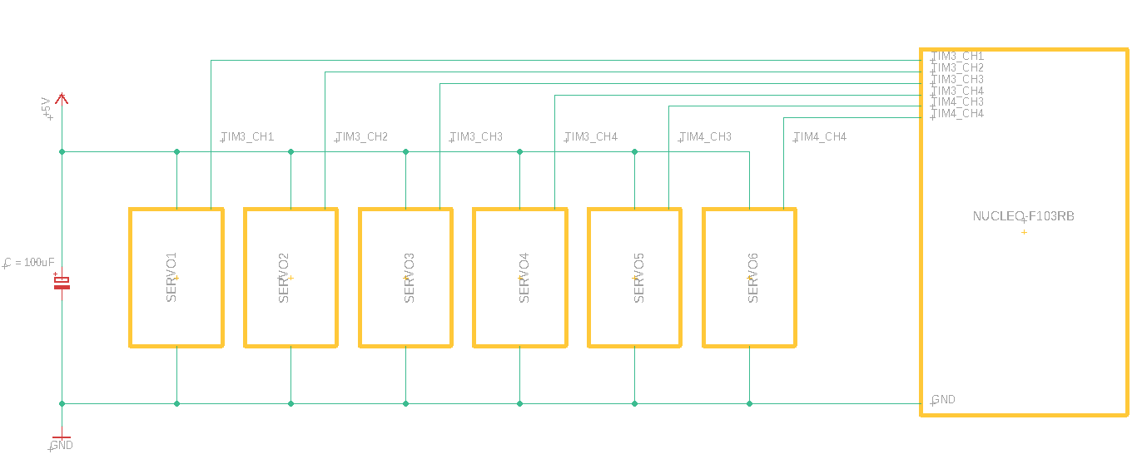
LaTeX_thesis/Thesis_images/Czesci_i_konstrukcja/Schemat_elektryczny.png
