Larook/STM_Stewart/LaTeX_thesis/Thesis_images/Czesci_i_konstrukcja/Wykorzystane_piny_mcu.png

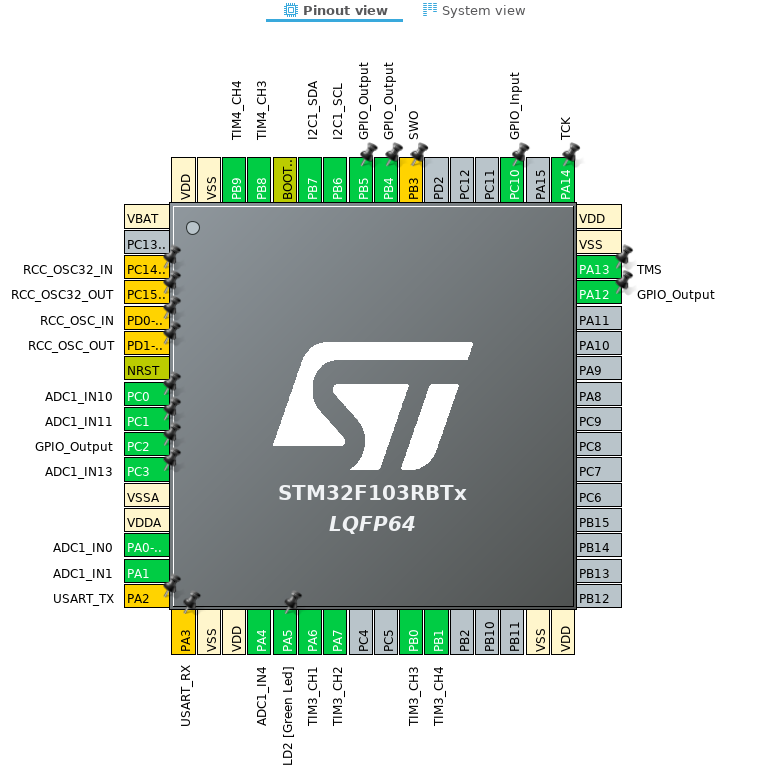
LaTeX_thesis/Thesis_images/Czesci_i_konstrukcja/Wykorzystane_piny_mcu.png
