Larook/STM_Stewart/LaTeX_thesis/Thesis_images/Inventor/serwo_orczyk_calosc.JPG

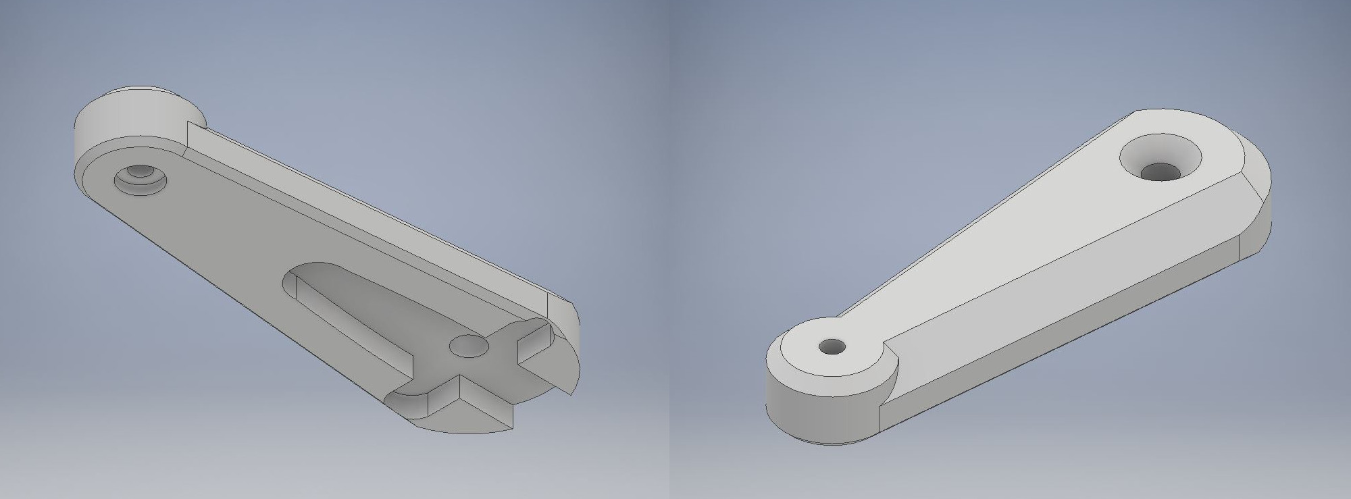
LaTeX_thesis/Thesis_images/Inventor/serwo_orczyk_calosc.JPG
