Larook/STM_Stewart/LaTeX_thesis/Thesis_images/Wstep/GoughPlatform.jpg

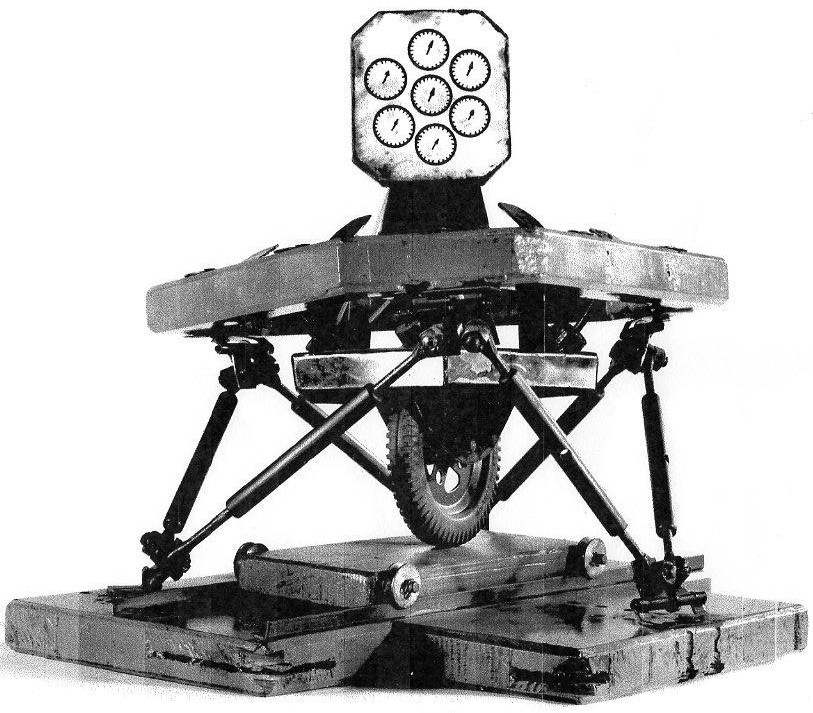
LaTeX_thesis/Thesis_images/Wstep/GoughPlatform.jpg
