Larook/STM_Stewart/STM_Stewart-final/LaTeX_thesis/Karol_Szurkowski-Stewart_Platform/img/6-DOF.jpg

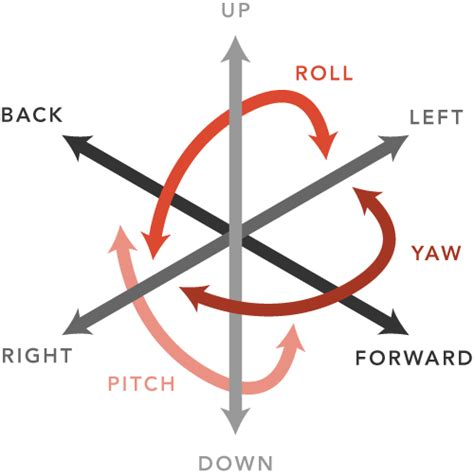
STM_Stewart-final/LaTeX_thesis/Karol_Szurkowski-Stewart_Platform/img/6-DOF.jpg
