Larook/STM_Stewart/STM_Stewart-final/LaTeX_thesis/Karol_Szurkowski-Stewart_Platform/img/Boeing_737_Full_Motion_Flight_Simulator-1024x768.jpg

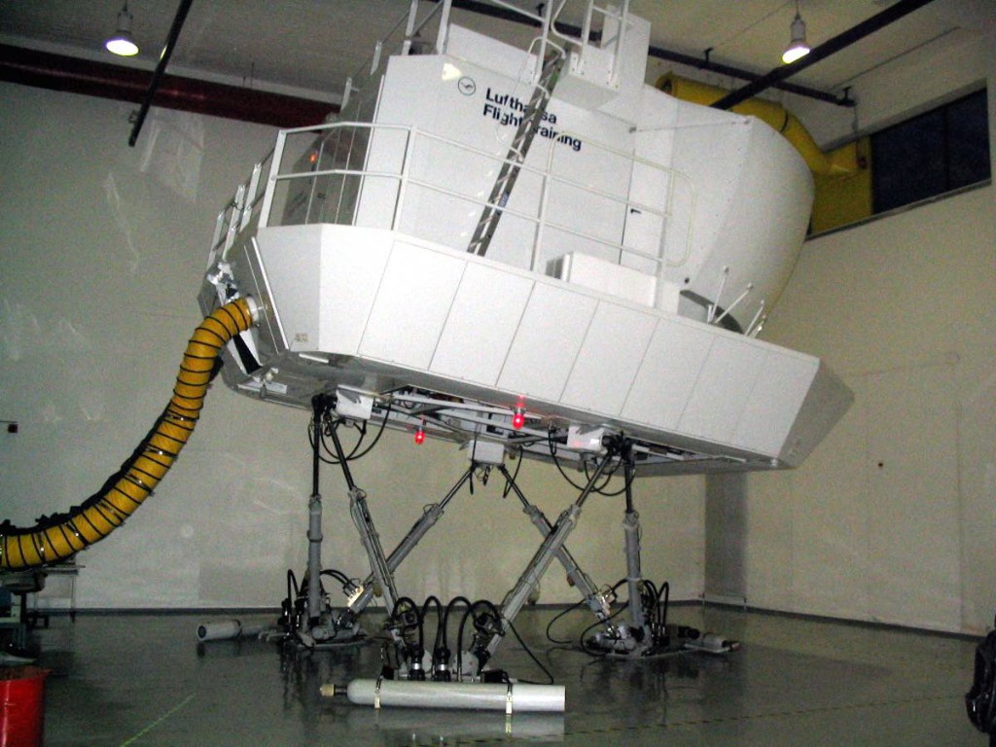
STM_Stewart-final/LaTeX_thesis/Karol_Szurkowski-Stewart_Platform/img/Boeing_737_Full_Motion_Flight_Simulator-1024x768.jpg
