Larook/STM_Stewart/STM_Stewart-final/LaTeX_thesis/Karol_Szurkowski-Stewart_Platform/img/GoughPlatform.jpg

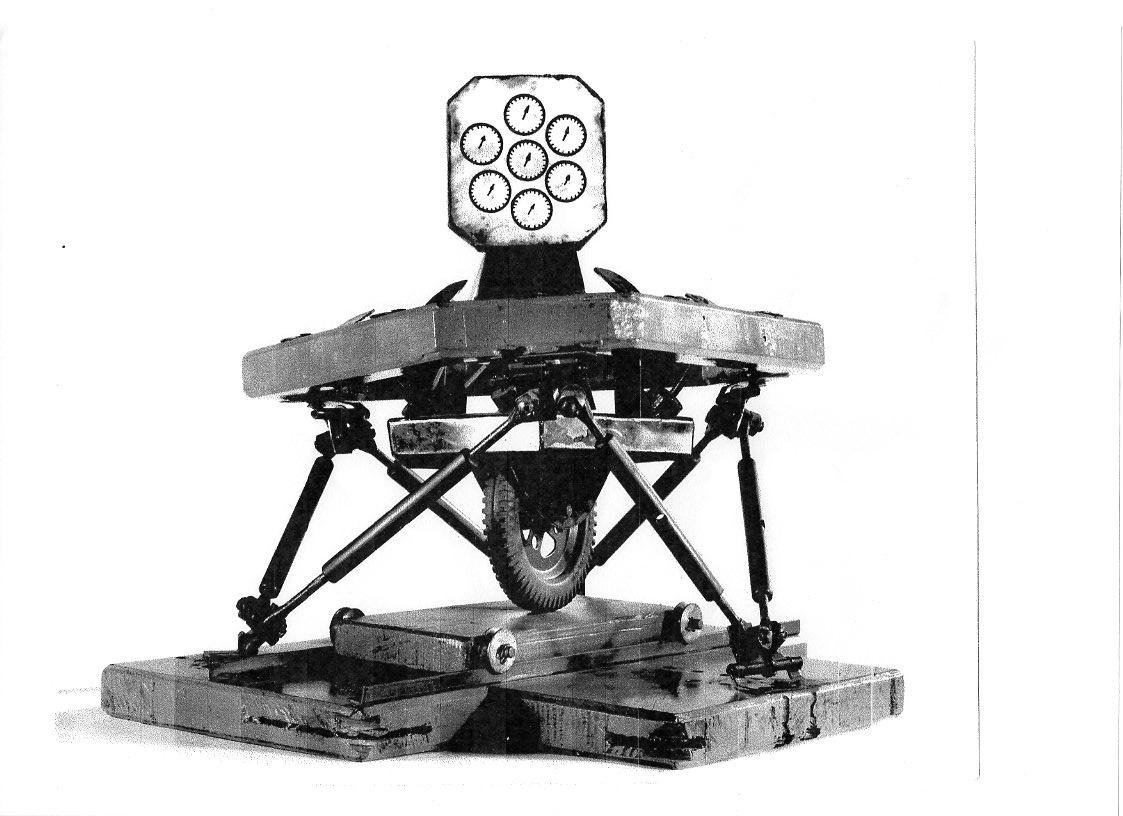
STM_Stewart-final/LaTeX_thesis/Karol_Szurkowski-Stewart_Platform/img/GoughPlatform.jpg
