Larook/STM_Stewart/STM_Stewart-final/LaTeX_thesis/Karol_Szurkowski-Stewart_Platform/img/medical_surgery_stewart.png

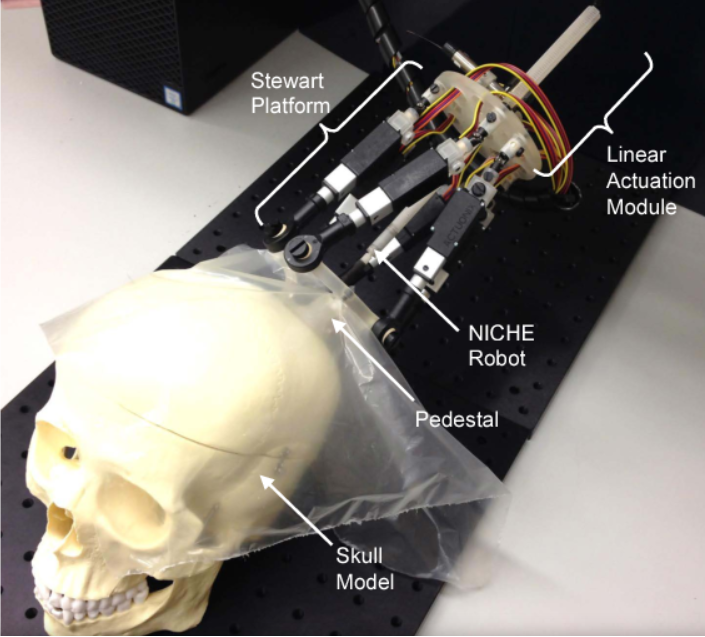
STM_Stewart-final/LaTeX_thesis/Karol_Szurkowski-Stewart_Platform/img/medical_surgery_stewart.png
