Larook/STM_Stewart/STM_Stewart-final/LaTeX_thesis/Karol_Szurkowski-Stewart_Platform/img/TopPlate_UP.JPG

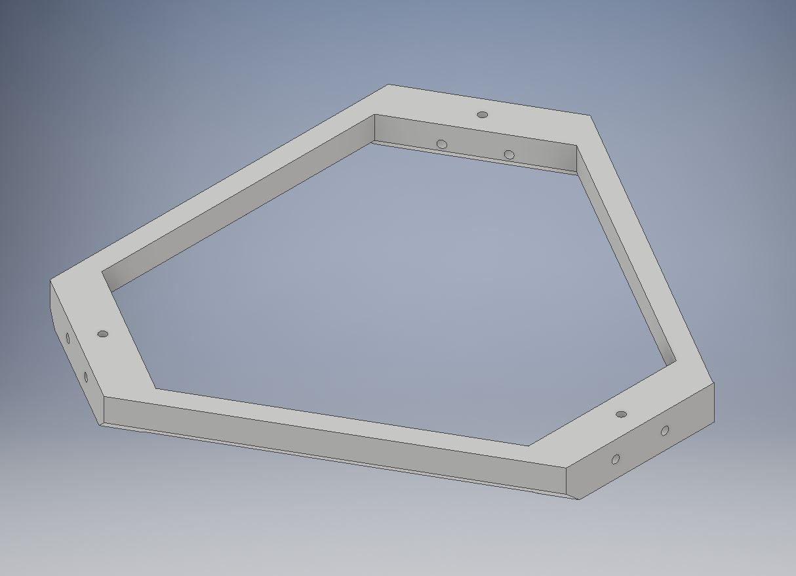
STM_Stewart-final/LaTeX_thesis/Karol_Szurkowski-Stewart_Platform/img/TopPlate_UP.JPG
