Larook/STM_Stewart/STM_Stewart-final/LaTeX_thesis/Karol_Szurkowski-Stewart_Platform/img/wybor_serwomechanizmu.png

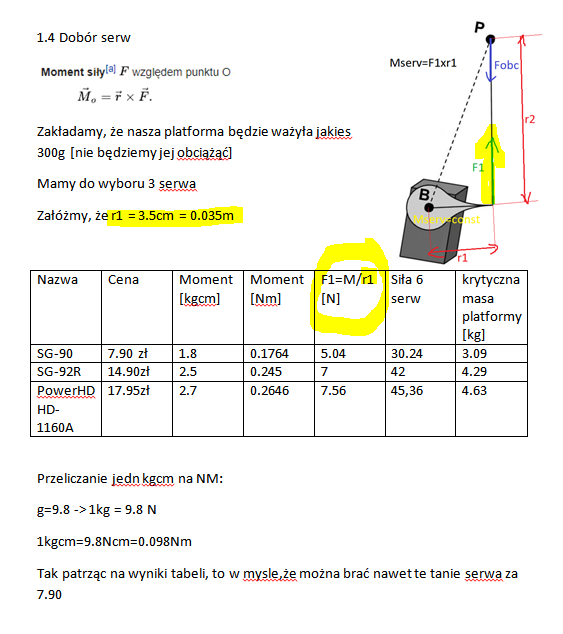
STM_Stewart-final/LaTeX_thesis/Karol_Szurkowski-Stewart_Platform/img/wybor_serwomechanizmu.png
