Larook/STM_Stewart/STM_Stewart-final/LaTeX_thesis/Thesis_images/Czesci_i_konstrukcja/NUCLEO-F103RB-5.png

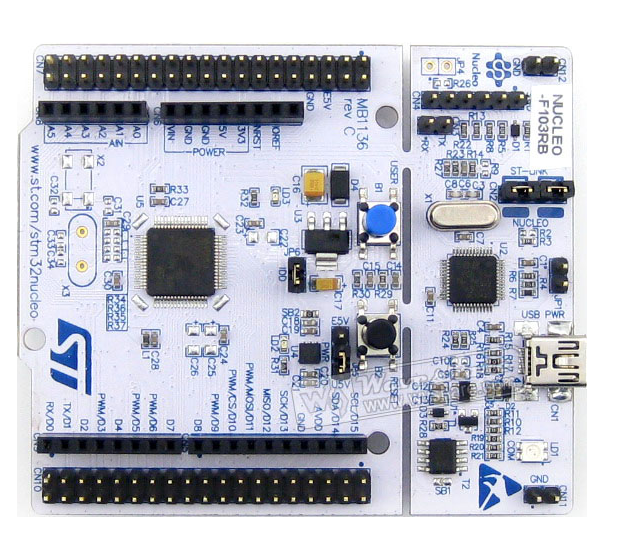
STM_Stewart-final/LaTeX_thesis/Thesis_images/Czesci_i_konstrukcja/NUCLEO-F103RB-5.png
