Larook/STM_Stewart/STM_Stewart-final/LaTeX_thesis/Thesis_images/Czesci_i_konstrukcja/Platforma_rzeczywista_wspolrzedne_1.jpg

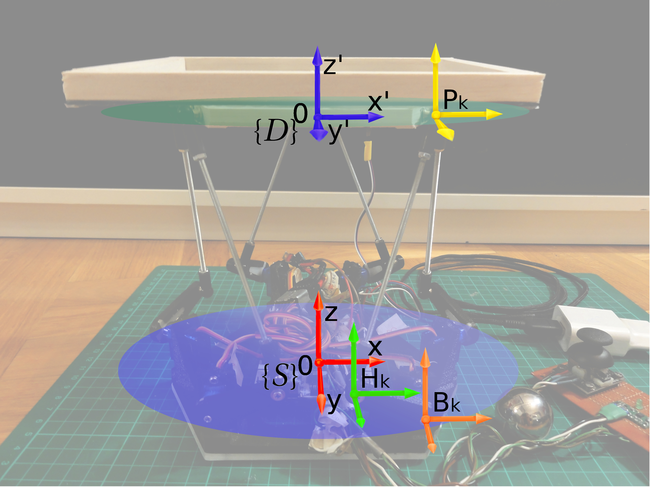
STM_Stewart-final/LaTeX_thesis/Thesis_images/Czesci_i_konstrukcja/Platforma_rzeczywista_wspolrzedne_1.jpg
