Larook/STM_Stewart/STM_Stewart-final/LaTeX_thesis/Thesis_images/Czesci_i_konstrukcja/projekt_2d_podstawy.png

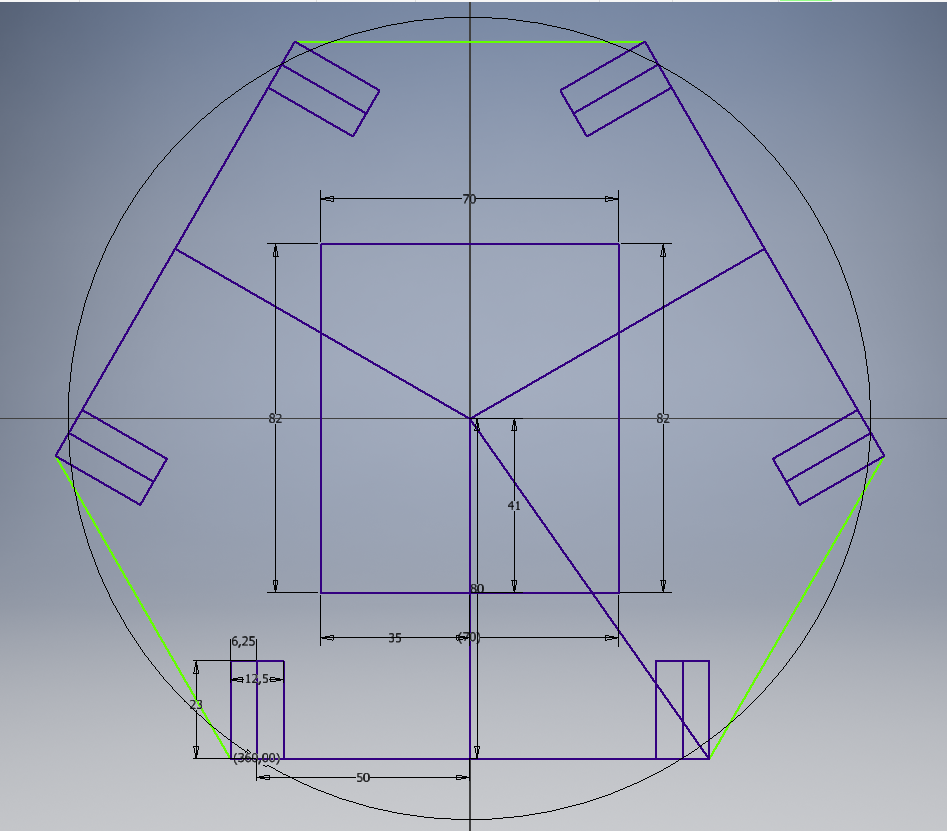
STM_Stewart-final/LaTeX_thesis/Thesis_images/Czesci_i_konstrukcja/projekt_2d_podstawy.png
