Larook/STM_Stewart/STM_Stewart-final/LaTeX_thesis/Thesis_images/Kinematyka_odwrotna/base_serwo_wymiary.png

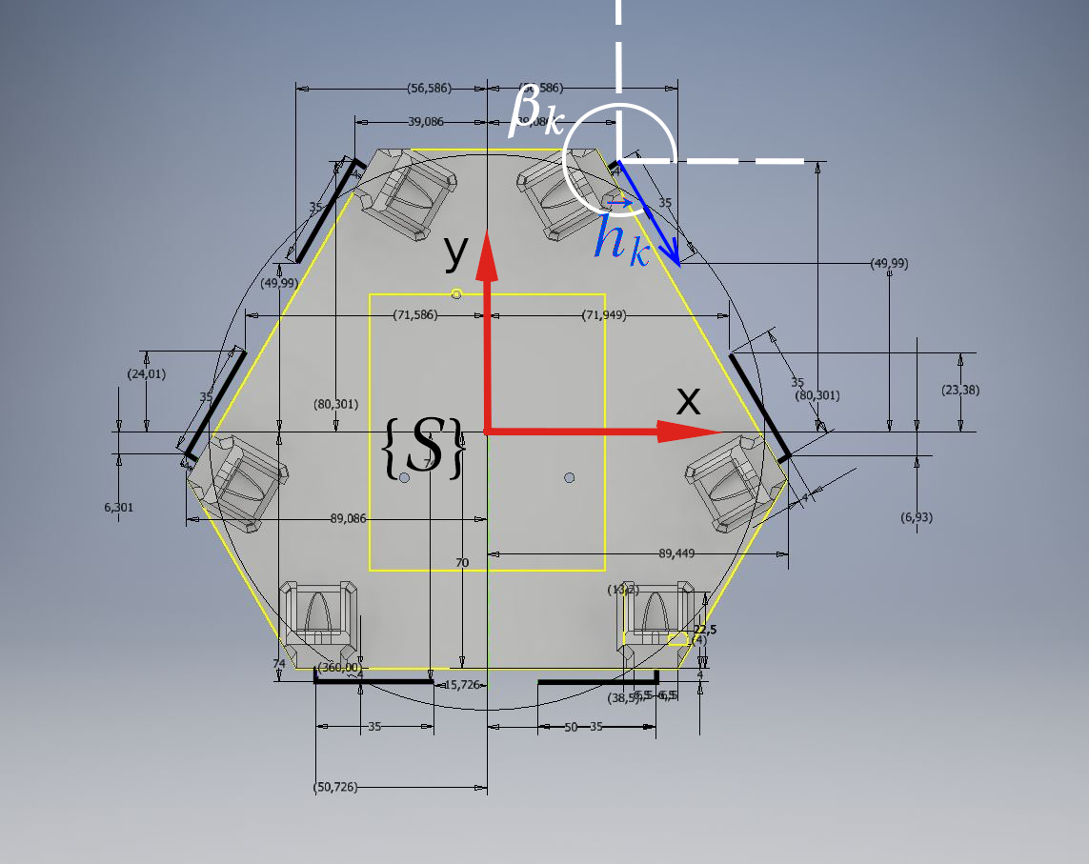
STM_Stewart-final/LaTeX_thesis/Thesis_images/Kinematyka_odwrotna/base_serwo_wymiary.png
