Larook/STM_Stewart/STM_Stewart-final/LaTeX_thesis/Thesis_images/Kinematyka_odwrotna/charakterystyka_serwa.png

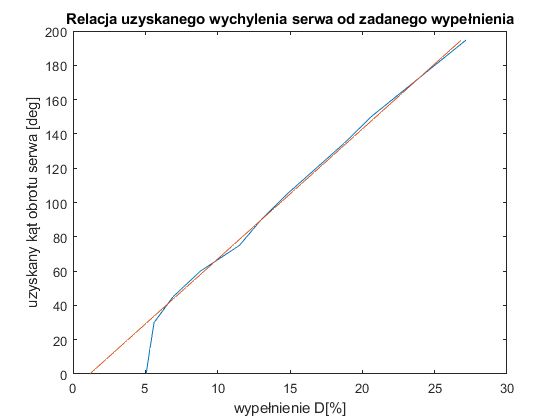
STM_Stewart-final/LaTeX_thesis/Thesis_images/Kinematyka_odwrotna/charakterystyka_serwa.png
