Larook/STM_Stewart/STM_Stewart-final/LaTeX_thesis/Thesis_images/Kinematyka_odwrotna/serwo_katy_alpha_beta.png

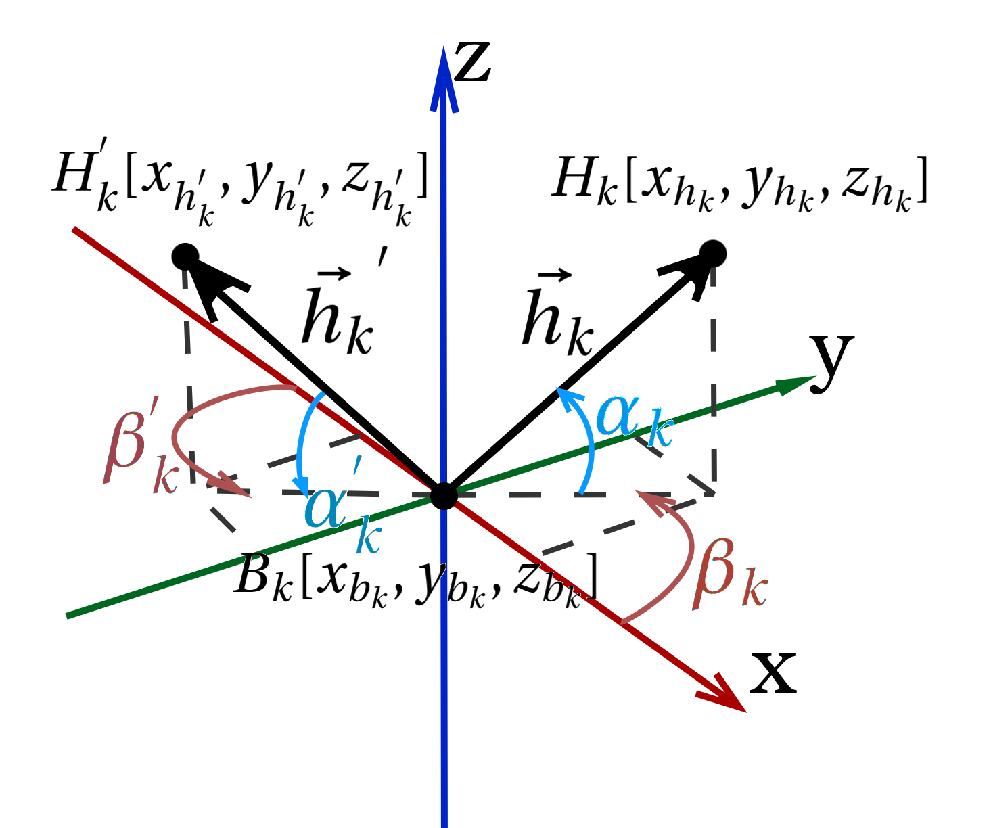
STM_Stewart-final/LaTeX_thesis/Thesis_images/Kinematyka_odwrotna/serwo_katy_alpha_beta.png
