Larook/STM_Stewart/STM_Stewart-final/LaTeX_thesis/Thesis_images/PID/kat_wychylenia_platformy.png

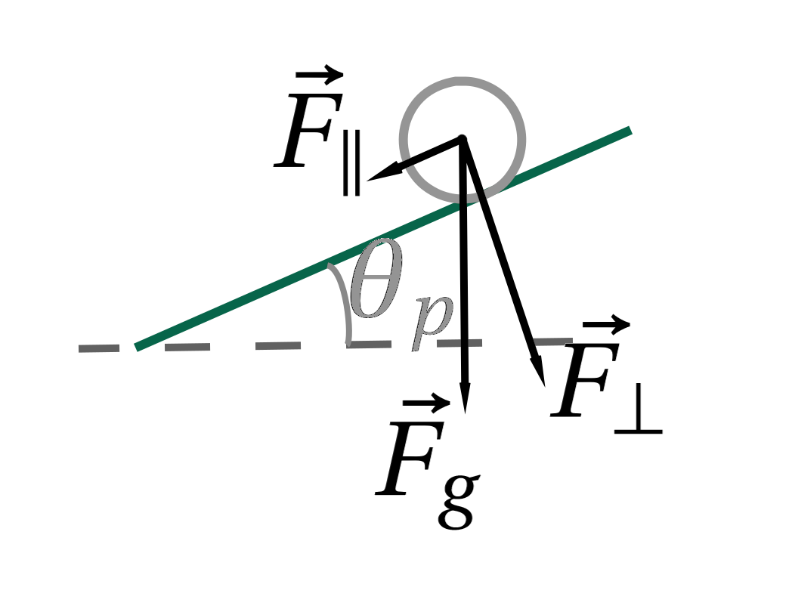
STM_Stewart-final/LaTeX_thesis/Thesis_images/PID/kat_wychylenia_platformy.png
