Larook/STM_Stewart/STM_Stewart-final/LaTeX_thesis/Thesis_images/TouchPanel/Odczytywanie_x_y_touchpanel.png

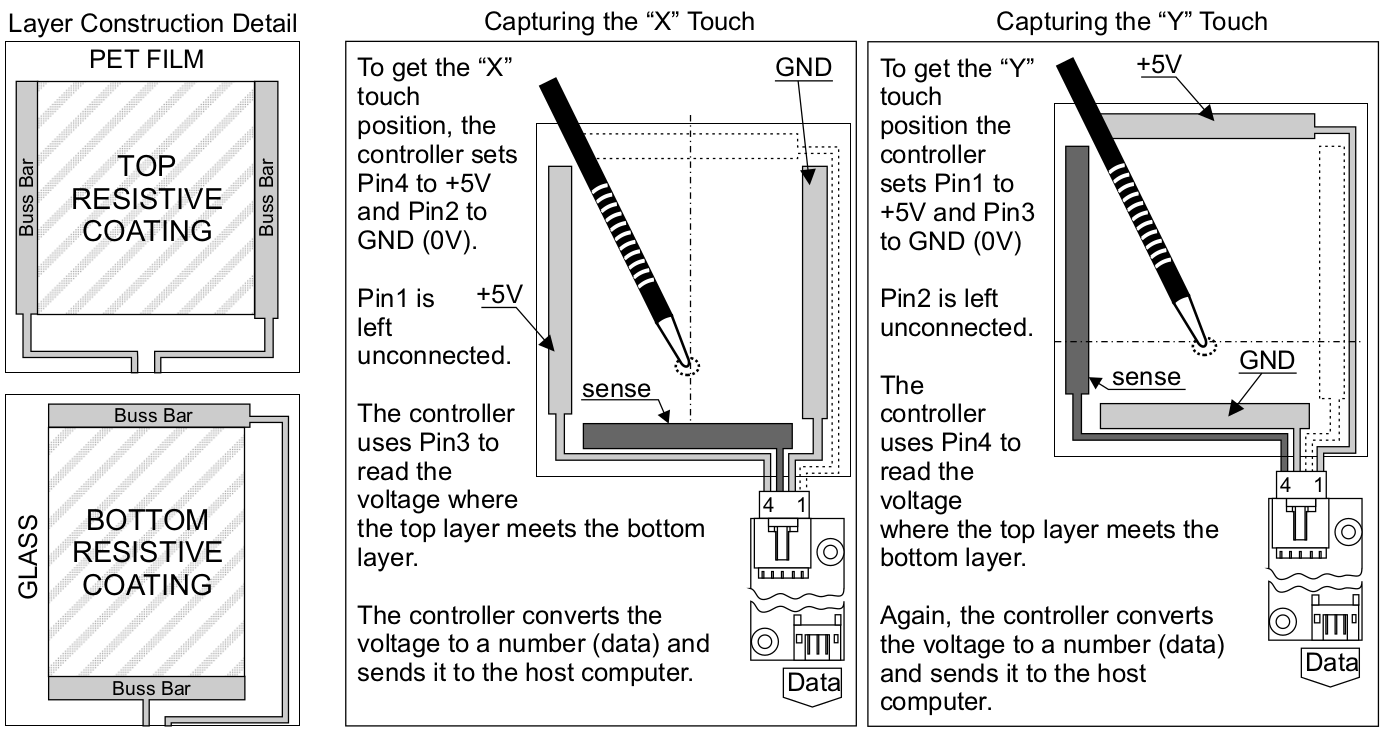
STM_Stewart-final/LaTeX_thesis/Thesis_images/TouchPanel/Odczytywanie_x_y_touchpanel.png
