Larook/STM_Stewart/STM_Stewart-final/LaTeX_thesis/Thesis_images/TouchPanel/touchpanel_budowa.png

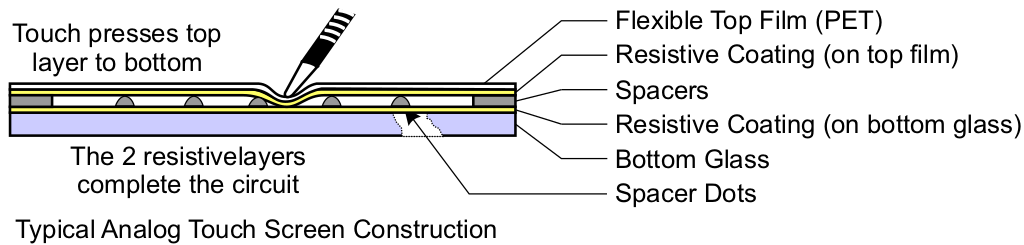
STM_Stewart-final/LaTeX_thesis/Thesis_images/TouchPanel/touchpanel_budowa.png
