Larook/STM_Stewart/STM_Stewart-final/LaTeX_thesis/Touch_panel/Post_wiele_ADC_zmiana_gpio_mode.JPG

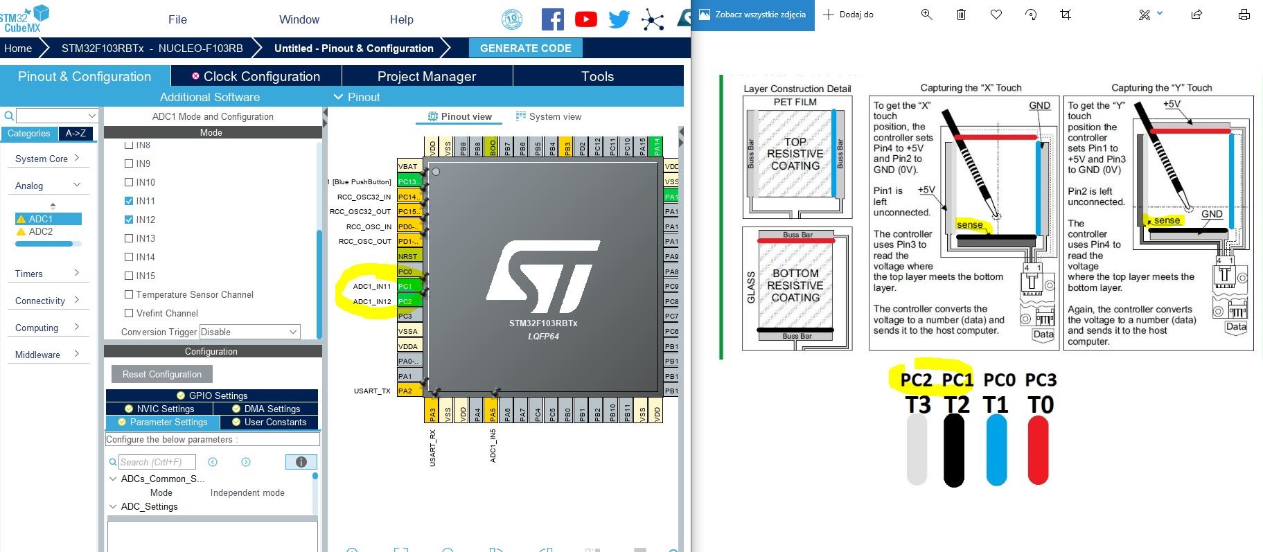
STM_Stewart-final/LaTeX_thesis/Touch_panel/Post_wiele_ADC_zmiana_gpio_mode.JPG
