Larook/STM_Stewart/STM_Stewart-final/LaTeX_thesis/Touch_panel/touch_panel_accuracy_display.jpg

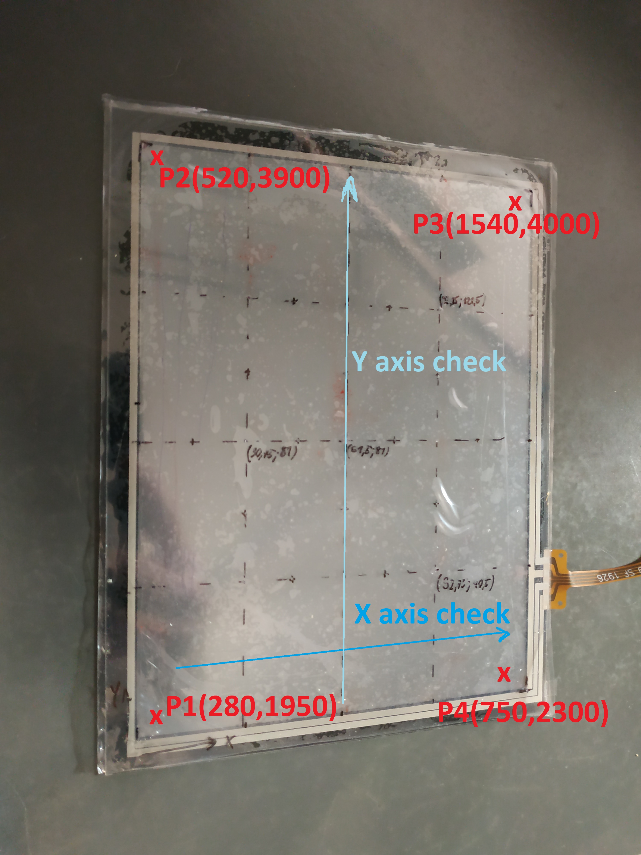
STM_Stewart-final/LaTeX_thesis/Touch_panel/touch_panel_accuracy_display.jpg
