Larook/STM_Stewart/STM_Stewart-final/LaTeX_thesis/Touch_panel/touch_panel_accuracy_display_checking_direction.jpg

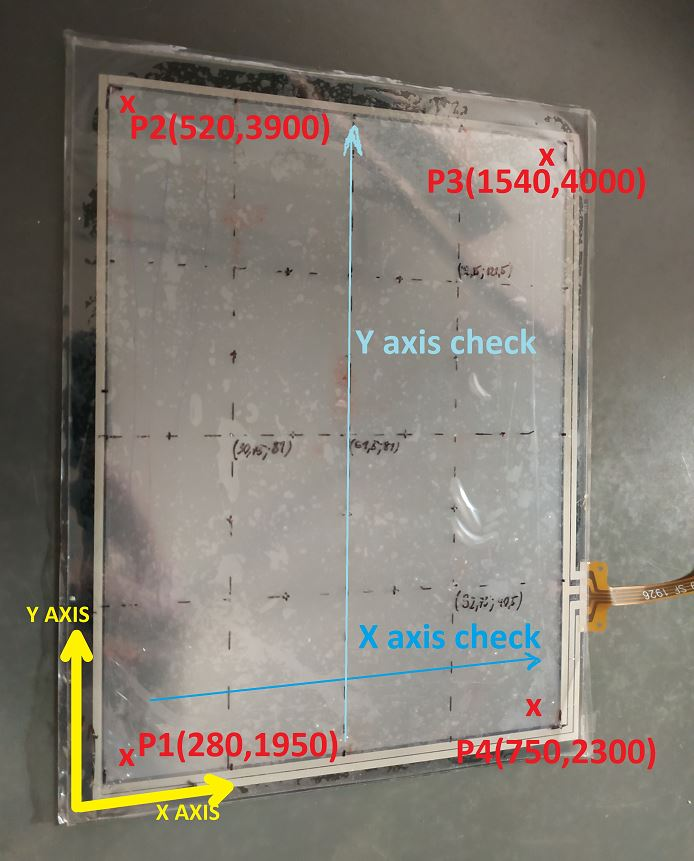
STM_Stewart-final/LaTeX_thesis/Touch_panel/touch_panel_accuracy_display_checking_direction.jpg
