Larook/STM_Stewart/STM_Stewart-final/LaTeX_thesis/Touch_panel/Y_axis_check.JPG

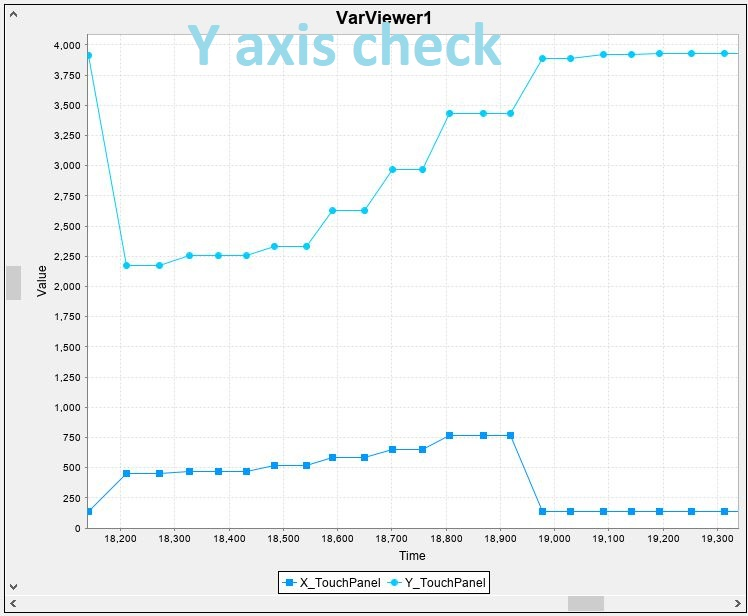
STM_Stewart-final/LaTeX_thesis/Touch_panel/Y_axis_check.JPG
