Larook/STM_Stewart/LaTeX_thesis/Thesis_images/Wstep/Example_construction_researchgate.png

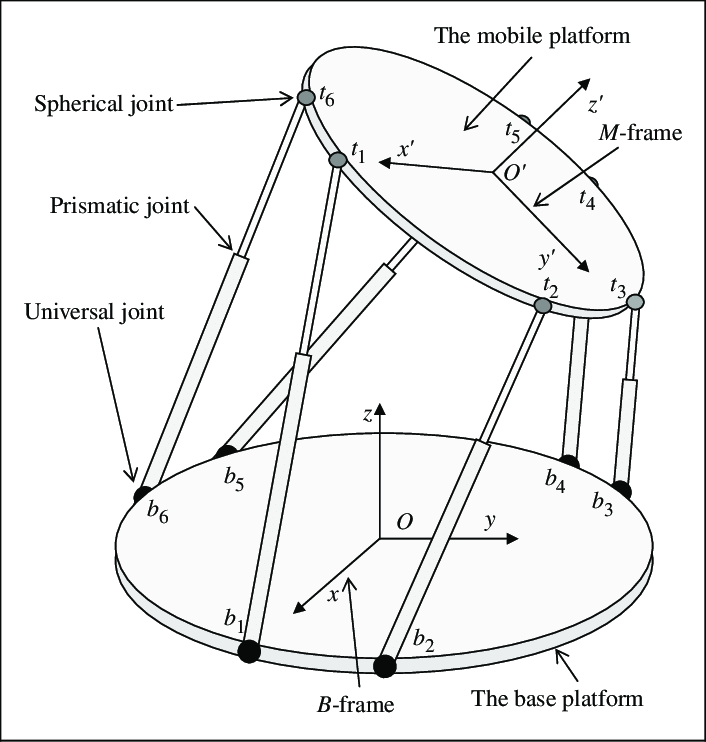
LaTeX_thesis/Thesis_images/Wstep/Example_construction_researchgate.png
