Larook/STM_Stewart/STM_Stewart-final/LaTeX_thesis/PID/pidx_test_Kp_0.2__Ki_0.018.JPG

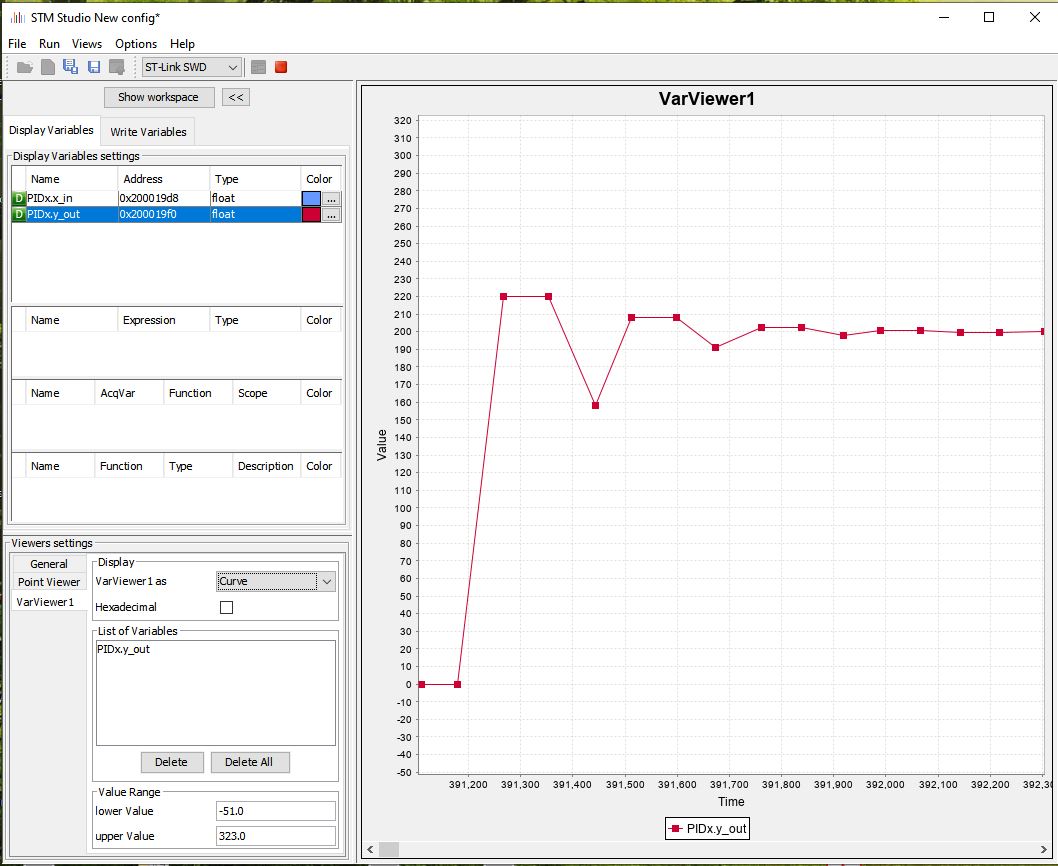
STM_Stewart-final/LaTeX_thesis/PID/pidx_test_Kp_0.2__Ki_0.018.JPG
