Larook/STM_Stewart/STM_Stewart-final/LaTeX_thesis/Thesis_images/TouchPanel/bledy_kalibracji_touchpanel.png

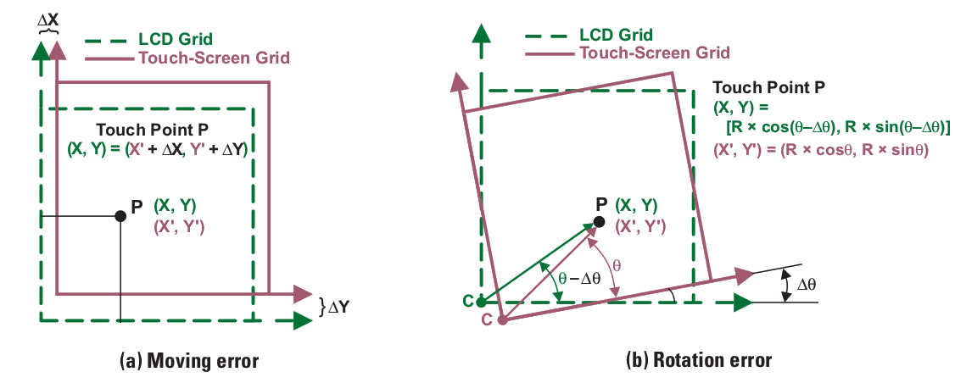
STM_Stewart-final/LaTeX_thesis/Thesis_images/TouchPanel/bledy_kalibracji_touchpanel.png
