Larook/STM_Stewart/CubeMX_project/Pinout_Stewart_Platform/Pinout_Stewart_Platform.ioc

Mcu.UserName=STM32F103RBTx
PA0-WKUP.Signal=ADCx_IN0
PA1.Signal=ADCx_IN1
PA12.Signal=GPIO_Output
PA13.GPIO_Label=TMS
PA13.Signal=SYS_JTMS-SWDIO
PA14.GPIO_Label=TCK
PA14.Signal=SYS_JTCK-SWCLK
PA2.GPIO_Label=USART_TX
PA2.Signal=USART2_TX
PA3.GPIO_Label=USART_RX
PA3.Signal=USART2_RX
PA4.Signal=ADCx_IN4
PA5.GPIO_Label=LD2 [Green Led]
PA5.Signal=GPIO_Output
PA6.Signal=S_TIM3_CH1
PA7.Signal=S_TIM3_CH2
PB0.Signal=S_TIM3_CH3
PB1.Signal=S_TIM3_CH4
PB3.GPIO_Label=SWO
PB3.Signal=SYS_JTDO-TRACESWO
PB4.Signal=GPIO_Output
PB5.Signal=GPIO_Output
PB6.Signal=I2C1_SCL
PB7.Signal=I2C1_SDA
PB8.Signal=S_TIM4_CH3
PB9.Signal=S_TIM4_CH4
PC0.Signal=ADCx_IN10
PC1.Signal=ADCx_IN11
PC10.Signal=GPIO_Input
PC14-OSC32_IN.Signal=RCC_OSC32_IN
PC15-OSC32_OUT.Signal=RCC_OSC32_OUT
PC2.Signal=GPIO_Output
PC3.Signal=ADCx_IN13
PD0-OSC_IN.Signal=RCC_OSC_IN
PD1-OSC_OUT.Signal=RCC_OSC_OUT
