Larook/STM_Stewart/STM_Stewart-final/Code/src/PID.h

/*
 * PID.h
 *
 *  Created on: 19.11.2019
 *      Author: PiK
 */
#include "main.h"

#ifndef PID_H_
#define PID_H_

typedef struct {
	/* parametry do anty-windupu */
	float limitHigh;
	float limitLow;

	/* wzmocnienia czesci Prop, calk i rozn */
	float Kp;
	float Ki;
	float Kd;

	float e_in; // wejscie
	float e_in_p;

	float yi_p; // poprzednia wartosc wyjscia calkujacego
	float yi; // wyjscie calkujace

	float yp; // wyjscie proporcjonalne

	float yd; // wyjscie rozniczkujace
	float yd_p;

	float y_out; // wyjscie jako suma PID
	float y_out_p; // y(n-1)
	float y_out_pp; // y(n-2)

	//test ograniczenia wyliczanych katow
	float next_angle;
	float next_angle_p;

} sPID_controller;

sPID_controller PIDx; // globalny regulator PIDx
sPID_controller PIDy;

float get_PID_output(sPID_controller *controller, int Ts);
float get_angle_from_PID_output(sPID_controller *controller,
		float g_inertia_const, float max_change);
void set_PID_params(sPID_controller *controller, float limitHigh,
		float limitLow, float Kp, float Ki, float Kd);

#endif /* PID_H_ */
