Larook/STM_Stewart/STM_Stewart-final/Code/src/delay.c

/*
 * delay.c
 *
 *  Created on: 08.02.2019
 *      Author: PiK
 */


//#include <stdint.h>
//#include "delay.h"
//
//volatile static uint32_t timer_ms = 0;
//
//void SysTick_Handler()
//{
//    if (timer_ms)
//        timer_ms--;
//}
//
//void delay_ms(int time)
//{
//    timer_ms = time;
//    while (timer_ms){
//    	;
//    }
//}
