Larook/STM_Stewart/(commit log)

2019-10-15 original i2c komendy z neta, ale trzeba pozmieniac
    [A_inz_Stewart_Platform Run.cfg]
2019-10-17 teraz po zmianach nie dziala a chcialem dodac ADC do panelu
2019-10-29 Zmienilem ADC i dodalem notatki pt co sprobowac
2019-11-11 Dodalem wskazniki i algorytm kalibracje, kod sie kompiluje, ale nie dziala i crashuje platforme - POPRAWIC WSKAZNIKI ITP
    [main.c, main.h, touchpanel.c, touchpanel.h]
2019-11-12 Fajnie, troche dziala. Niestety nalezy poprawic funkcje obliczajaca punkt rzeczywisty. Problem moze lezec w floatach, lub nieprawidlowym algorytmie. Tez trzeba pamietac, ze gdzies w parametrach panel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
    [enable_things.c, main.c, main.h, touchpanel.c, touchpanel.h]
2019-11-13 Ok dziala wszystko ladnie na wskaznikach do struktur w przerwaniach. Panel dotykowy dziala i wyswietla wartosci w mm. Mozna juz implementowac PID i rownolegle zdobyc lepsza kulke (pewnie lozysko, ale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
2019-11-19 Dodalem strukture i inicjalizacje regulatora PID, ale nie testowalem jak dziala
2019-11-25 Dodalem i sprawdzilem real-time regulator PI. Teraz trzeba ogarnac jak zamieniac roznice polozenia na kat (w papersach jest mowa o podwojnym rozniczkowaniu
2019-11-26 Wyglada na to ze PID dziala, ale integracja z Plantem jeszcze nie do konca. Dlaczego dziala tylko PIDy? Dlaczego Roll jest mylony z Pitch? Jaka ma byc wartosc const w get_angle_from_PID?
2019-11-27 OK, chyba w koncu dziala!!!! Trzeba tylko ogaranc te ciezsza pilke, a potem w razie czego pozmieniac parametry (pid i przeliczanie na kat), a takze mozna kombinowac ze zwiekszeniem taktowania przerwa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
2019-12-01 Trzeba popracowac nad PID - zrobic tuning i upewnic sie ze czesc D jest prawidlowo zaimplementowana
2019-12-02 Sprawdzilem w necie i PID zdaje sie teraz byc dobrze zaimplementowany. Ts okazal sie potrzebny. Poprawilem ograniczenia wchodzenia serwa w krytyczna pozycje. Niestety nadal trzeba usprawnic tuning. P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
    [PID.c, PID.h, kinematics.c, main.c]
2019-12-03 set_PID_params(&PIDx, 1100, -1100, 0.0000000164, 0.0904000658754995, 0.0000163); //konstruktor do regulatora PID osi X D=0.0001 Wydaja sie to calkiem ok nastawy, ale moze by tak zrezygnowac troche z 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
2019-12-11 Robie porzadki
    [A_inz_Stewart_Platform Run.cfg]
2019-12-12 Rysunek katow beta i alfa serwa. Trzeba wyjasnic wzory albo zapytac Wiraszki czy mozna wrzucic odnosnik
2019-12-13 Dodalem skrypty z touchpanelem, PID, oraz przykladowe papers
2019-12-17 znowu nastawy regulatorow
2019-12-19 Dodalem funkcje szpanujace- pokazujace ruch i znalzlem blad! W get_next_angle zamiast drugiego - powinien byc +. Do tego dorzucam prezke bez filmow
    [A_inz_Stewart_Platform Run.cfg]
2019-12-23 Sprobowalem posterowac zmieniajac obliczenia PID i generalnie calkowanie / rozniczkowanie nie wykorzystujac Ts do obliczen. Niestety kurde nie bangla dobrze, ale chyba jest lepiej.
2020-01-26 Dodano caly osobny projekt z doborem nastaw regulatora
    [A_inz_Stewart_Platform Run.cfg]
2022-07-25 added step response PID
